xmyoot/esp32-p4-midi-lte/docs/client_brief/job_post_1_summary.png

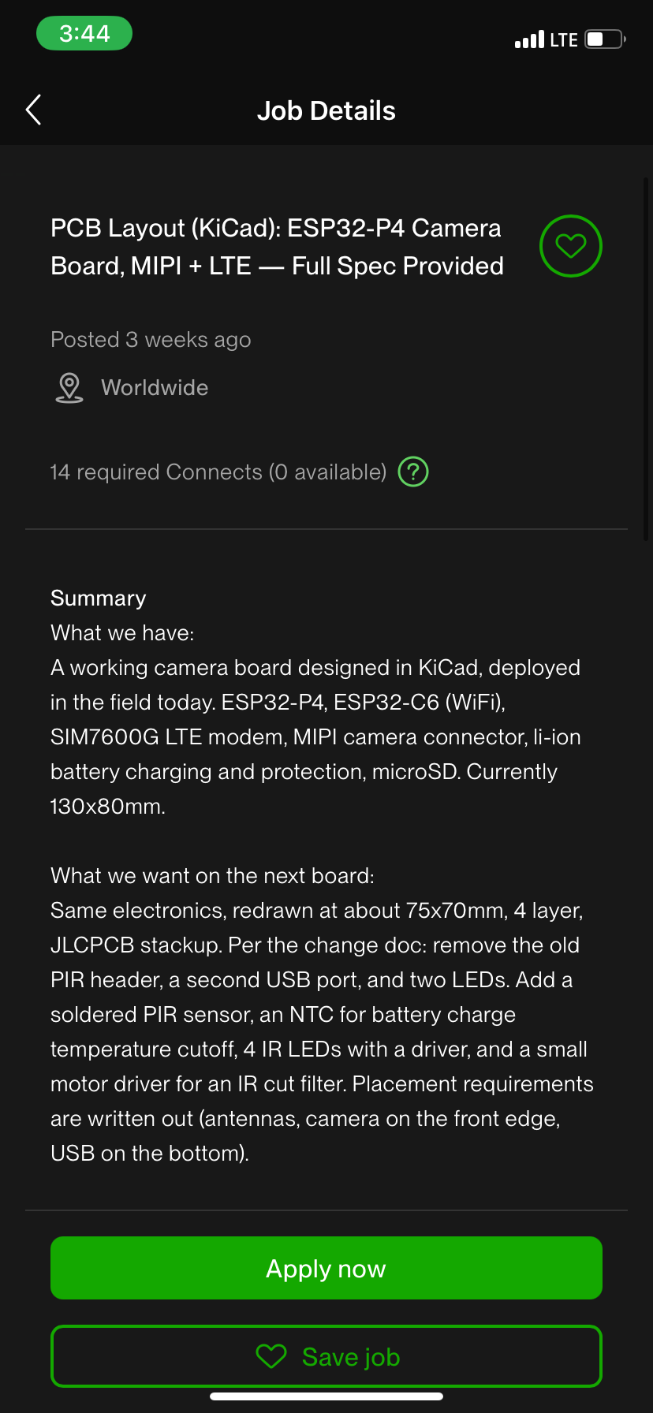
docs/client_brief/job_post_1_summary.png
