xmyoot/esp32-p4-midi-lte/docs/client_brief/job_post_2_deliverables.png

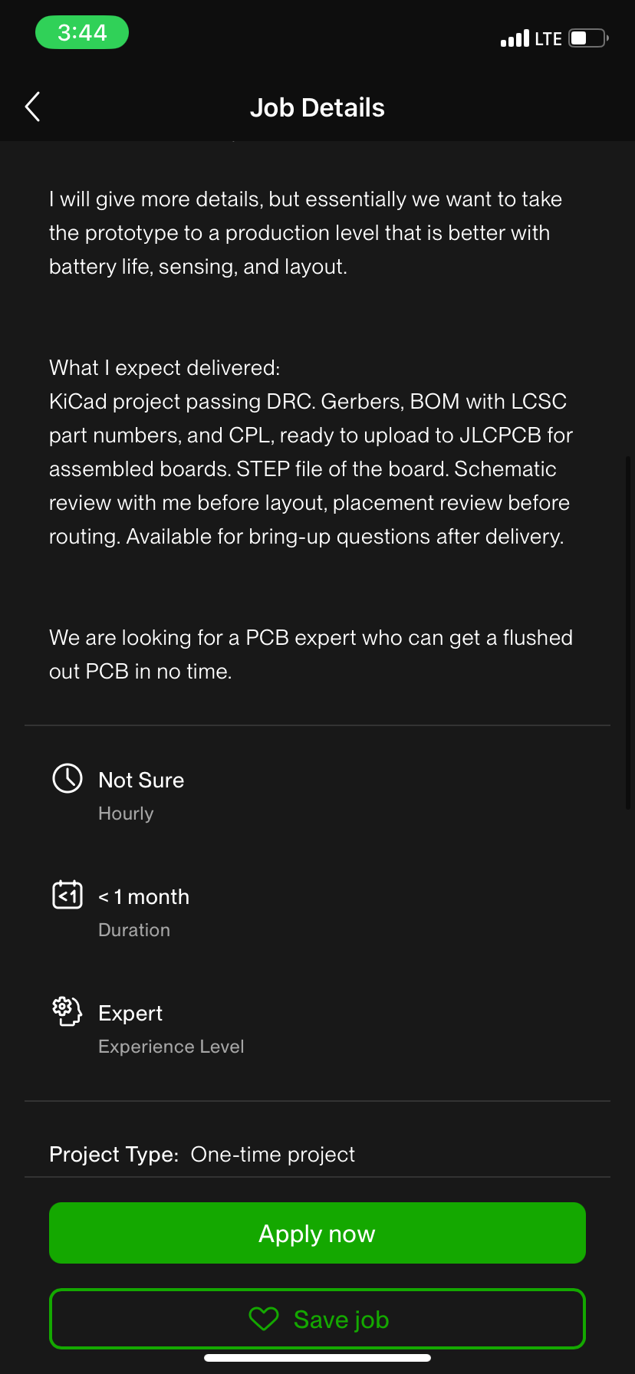
docs/client_brief/job_post_2_deliverables.png
