xmyoot/esp32-p4-midi-lte/docs/review/bom_revA_draft.csv

Refs | Value | Footprint | LCSC | MPN | Qty | DNP
C201 | 1u 25V | Capacitor_SMD:C_0603_1608Metric | C5673 | CL10A105KA8NNNC | 1
C202 | 10u 25V | Capacitor_SMD:C_0805_2012Metric | C15850 | CL21A106KAYNNNE | 1
C203,C328,C610 | 4.7u 10V | Capacitor_SMD:C_0603_1608Metric | C1705 | CL10A475KP8NNNC | 3
C204 | 47n 16V | Capacitor_SMD:C_0402_1005Metric | C307434 | CL05B473KO5NNNC | 1
C205,C206,C207,C508,C605,C607 | 10u 10V | Capacitor_SMD:C_0805_2012Metric | C17024 | CL21A106KPFNNNE | 6
C208,C213,C301,C302,C303,C304,C305,C306,C307,C311,C312,C313,C314,C317,C319,C320,C323,C326,C331,C336,C402,C504,C511,C512,C516,C602,C609,C611,C703 | 100n | Capacitor_SMD:C_0402_1005Metric | C1525 | CL05B104KO5NNNC | 29
C209,C211,C212,C330 | 22u 10V | Capacitor_SMD:C_0805_2012Metric | C380338 | TCC0805X5R226M100FT | 4
C214,C215,C316,C318,C321,C322,C325,C327,C403,C507,C604,C705 | 1u | Capacitor_SMD:C_0402_1005Metric | C52923 | CL05A105KA5NQNC | 12
C308,C309,C310,C315,C401,C503,C601,C702 | 10u 10V | Capacitor_SMD:C_0603_1608Metric | C19702 | CL10A106KP8NNNC | 8
C324 | 10n | Capacitor_SMD:C_0402_1005Metric | C15195 | CL05B103KB5NNNC | 1
C329,C332,C333 | 22p | Capacitor_SMD:C_0402_1005Metric | C1555 | 0402CG220J500NT | 3
C334,C335 | 18p | Capacitor_SMD:C_0402_1005Metric | C1549 | 0402CG180J500NT | 2
C501,C502 | 220u 6.3V | Capacitor_Tantalum_SMD:CP_EIA-3528-21_Kemet-B | C30242 | TLJB227M006R0500 | 2
C505,C513,C514,C515 | 33p | Capacitor_SMD:C_0402_1005Metric | C1562 | 0402CG330J500NT | 4
C506 | 10p | Capacitor_SMD:C_0402_1005Metric | C32949 | CL05C100JB5NNNC | 1
C509,C603,C704 | 1n 25V | Capacitor_SMD:C_0402_1005Metric | C541372 | CC0402KRX7R8BB102 | 3
C510,C608 | 100n 16V | Capacitor_SMD:C_0402_1005Metric | C1525 | CL05B104KO5NNNC | 2
C606 | 4.7u 25V | Capacitor_SMD:C_0805_2012Metric | C1779 | CL21A475KAQNNNE | 1
D201 | SMF5.0A (TVS) | Diode_SMD:D_SOD-123F | C193402 | SMF5.0A | 1
D601 | B5819W | Diode_SMD:D_SOD-123 | C8598 | B5819W SL | 1
D602,D603,D604,D605 | IR 850nm | lcsc:LED-SMD_3P-L3.8-W3.8_M3838E1IRS1G09 | C2833567 | M3838E1IRS1G09-850NM | 4
J1 | USB-C (bottom edge) | Connector_USB:USB_C_Receptacle_HRO_TYPE-C-31-M-12 | C165948 | TYPE-C-31-M-12 | 1
J2 | CAM FPC 22P 0.5mm | lcsc:CONN-SMD_05B20L22P | C22459552 | 05B20L22P | 1
J3 | microSD | lcsc:TF-SMD_TF-01A | C91145 | TF-01A | 1
J4 | Nano-SIM | lcsc:SIM-SMD_NANO-SIM-7P-H1.37 | C7529384 | NANO SIM 7P H1.37 | 1
J5 | U.FL MAIN | lcsc:RF-SMD_FRF05002-JSS103M | C88374 | U.FL-R-SMT-1(80) | 1
J6 | U.FL AUX | lcsc:RF-SMD_FRF05002-JSS103M | C88374 | U.FL-R-SMT-1(80) | 1
J7 | U.FL GNSS | lcsc:RF-SMD_FRF05002-JSS103M | C88374 | U.FL-R-SMT-1(80) | 1
J8 | BATT (+ / NTC / -) | Connector_JST:JST_PH_S3B-PH-SM4-TB_1x03-1MP_P2.00mm_Horizontal | C265101 | S3B-PH-SM4-TB(LF)(SN) | 1
J9 | IR-CUT | Connector_JST:JST_SH_SM02B-SRSS-TB_1x02-1MP_P1.00mm_Horizontal | C160402 | SM02B-SRSS-TB(LF)(SN) | 1
L201 | 2.2uH | lcsc:IND-SMD_L5.0-W5.0_SMNR5030 | C189797 | SMNR5030-2R2N | 1
L202 | 1uH | Inductor_SMD:L_1008_2520Metric | C98348 | WPN252012H1R0MT | 1
L301 | 2.2uH | Inductor_SMD:L_1008_2520Metric | C5832372 | FTC252012S2R2MBCA | 1
L601 | 10uH | lcsc:IND-SMD_L4.0-W4.0 | C38117 | SWPA4030S100MT | 1
Q201 | FS8205A | lcsc:SOT-23-6_L2.9-W1.6-P0.95-LS2.8-BR | C2830320 | FS8205A | 1
Q501,Q502 | 2N7002 | Package_TO_SOT_SMD:SOT-23 | C8545 | 2N7002 | 2
R201,R202 | 5.1k | Resistor_SMD:R_0402_1005Metric | C25905 | 0402WGF5101TCE | 2
R203,R204,R304,R305,R306,R307,R308,R309,R316,R317,R318,R319,R320,R321,R509,R510,R511 | 0 | Resistor_SMD:R_0402_1005Metric | C17168 | 0402WGF0000TCE | 17
R205 | 120 | Resistor_SMD:R_0402_1005Metric | C25079 | 0402WGF1200TCE | 1
R206 | 5.23k | Resistor_SMD:R_0402_1005Metric | C2933105 | FRC0402F5231TS | 1
R207 | 30.1k | Resistor_SMD:R_0402_1005Metric | C29402 | 0402WGF3012TCE | 1
R208,R209,R210,R310,R312,R313,R401,R402,R403,R404,R405,R406,R407,R408,R508,R603,R702,R703,R704,R705,R706,R707 | 10k | Resistor_SMD:R_0402_1005Metric | C25744 | 0402WGF1002TCE | 22
R211,R609 | 100 | Resistor_SMD:R_0402_1005Metric | C25076 | 0402WGF1000TCE | 2
R212,R311 | 1k | Resistor_SMD:R_0402_1005Metric | C11702 | 0402WGF1001TCE | 2
R213 | 560k | Resistor_SMD:R_0402_1005Metric | C137958 | RC0402FR-07560KL | 1
R214,R501,R502,R503,R504,R605,R607,R608,R708 | 100k | Resistor_SMD:R_0402_1005Metric | C25741 | 0402WGF1003TCE | 9
R301 | 4.02k | Resistor_SMD:R_0402_1005Metric | C43251 | 0402WGF4021TCE | 1
R302,R303 | 499k | Resistor_SMD:R_0402_1005Metric | C2998054 | FRC0402F4993TS | 2
R314,R315,R505,R506,R507,R701 | 22 | Resistor_SMD:R_0402_1005Metric | C25092 | 0402WGF220JTCE | 6
R601,R602 | 2.2k | Resistor_SMD:R_0402_1005Metric | C25879 | 0402WGF2201TCE | 2
R606 | 0.68 | Resistor_SMD:R_0805_2012Metric | C47389 | 0805W8F680LT5E | 1
SW301 | RESET | lcsc:SW-SMD_L4.0-W2.9-P4.15-EH | C455278 | TS-1088C-02026 | 1
SW302 | BOOT | lcsc:SW-SMD_L4.0-W2.9-P4.15-EH | C455278 | TS-1088C-02026 | 1
U1 | ESP32-P4NRW32X | espressif:ESP32-P4 | C54540373 | ESP32-P4NRW32X | 1
U2 | W25Q128JVSIQ | Package_SO:SOIC-8_5.3x5.3mm_P1.27mm | C97521 | W25Q128JVSIQ | 1
U3 | ESP32-C6-MINI-1 | espressif:ESP32-C6-MINI-1 | C5453904 | ESP32-C6-MINI-1-N4 | 1
U4 | SIM7600G-H | lcsc:COMM-SMD_135P-L30.0-W30.0_SIM7600G | C5355477 | SIM7600G-H | 1
U5 | BQ25895RTWR | Package_DFN_QFN:Texas_RTW_WQFN-24-1EP_4x4mm_P0.5mm_EP2.7x2.7mm_ThermalVias | C80200 | BQ25895RTWR | 1
U6 | TPS631000 | lcsc:SOT-583-8_L2.1-W1.2-P0.50-LS1.6-BL | C5219190 | TPS631000DRLR | 1
U7 | TLV62569 | Package_TO_SOT_SMD:SOT-23-5 | C141836 | TLV62569DBVR | 1
U8 | TPS7A0218 | lcsc:SOT-23-5_L3.0-W1.7-P0.95-LS2.8-BL | C5144851 | TPS7A0218DBVR | 1
U9 | TPS22965 | lcsc:UDFN-8_L2.0-W2.0-P0.50-TL-EP | C122837 | TPS22965DSGR | 1
U10,U11 | TPS22918 | lcsc:SOT-23-6_L2.9-W1.6-P0.95-LS2.8-BR | C131941 | TPS22918DBVR | 2
U12 | TPS61169 | lcsc:SC-70-5_L2.1-W1.3-P0.65-LS2.1-BR | C71045 | TPS61169DCKR | 1
U13 | DRV8837 | Package_SON:Texas_DSG0008A_WSON-8-1EP_2x2mm_P0.5mm_EP0.9x1.6mm | C39159 | DRV8837DSGR | 1
U14 | DW01A | Package_TO_SOT_SMD:SOT-23-6 | C351410 | DW01A | 1
U15 | TPS3839G33 (3.08V) | Package_TO_SOT_SMD:SOT-23 | C485802 | TPS3839G33DBZR | 1
U16 | SN74LVC1T45 | Package_TO_SOT_SMD:SOT-23-6 | C7843 | SN74LVC1T45DBVR | 1
U17,U18 | TPD4E05U06 | Package_SON:USON-10_2.5x1.0mm_P0.5mm | C138714 | TPD4E05U06DQAR | 2
U19 | XYC-PIR223D-S0 | lcsc:TO-5-3_L8.2-W8.2 | C2887901 | XYC-PIR223D-S0 | 1
Y1 | 40MHz 10ppm | Crystal:Crystal_SMD_3225-4Pin_3.2x2.5mm | C9010 | X322540MPB4SI | 1
Y2 | 32.768kHz | Crystal:Crystal_SMD_3215-2Pin_3.2x1.5mm | C32346 | Q13FC13500004 | 1
