xmyoot/esp32-p4-midi-lte/docs/BOARD_SETUP.md

# Phase 3 — Board setup

Generated by `scripts/build_pcb.py` (netlist → PCB sync) and `scripts/board_setup.py` (idempotent).

## Board

| Item | Value |
|---|---|
| Outline | 75 × 70 mm, R2 corners. Origin top-left. Aux/grid origin bottom-left (0, 70) for the CPL |
| Mounting | 4 × M2.5 plated (GND), H1–H4 at (3.5, 9.5), (71.5, 9.5), (3.5, 66.5), (71.5, 66.5) |
| Fab | JLCPCB 4-layer, 1.6 mm, ENIG, **Standard PCBA** (required for the 0.35 mm-pitch QFN and the THT PIR) |

## Stackup — JLC04161H-7628

| Layer | Use | Thickness | Dk |
|---|---|---|---|
| F.Cu (L1) | Components, RF, MIPI, USB, short high-speed | 35 µm | — |
| prepreg 7628 | | 0.2104 mm | 4.4 |
| In1.Cu (L2) | **Solid GND plane** (zone `GND_L2`, full board) | 15.2 µm | — |
| core | | 1.065 mm | 4.6 |
| In2.Cu (L3) | Power pours (SYS, 3V3, VBAT_LTE) + low-speed signals | 15.2 µm | — |
| prepreg 7628 | | 0.2104 mm | 4.4 |
| B.Cu (L4) | Signals, GND fill | 35 µm | — |

## Controlled impedance (L1 over L2)

From `scripts/impedance.py`: Hammerstad–Jensen microstrip, the IPC-2141A coupled approximation, and Wadell grounded-CPW. Expect ±5 %. **Confirm in the JLCPCB impedance calculator and order impedance control.**

| Interface | Target | Geometry | Model result |
|---|---|---|---|
| LTE/GNSS RF feeds | 50 Ω CPWG | w 0.30 mm, gap 0.20 mm | 47.0 Ω (thickness-corrected CPWG) to 53.7 Ω (microstrip bound) |
| USB 2.0 FS (USB-Serial/JTAG) | 90 Ω diff | w 0.22 mm, s 0.13 mm | 90.8 Ω |
| MIPI CSI-2 D-PHY | **100 Ω diff** | w 0.17 mm, s 0.13 mm | 100.6 Ω |
| Reference | 50 Ω microstrip | w 0.346 mm | Matches JLC's published value for this stackup |

## Rules (JLC capability-checked 2026-10-19)

| Rule | Value | JLC limit |
|---|---|---|
| Min track / clearance | 0.10 / 0.10 mm (0.09 inside the U1 courtyard) | 0.09 / 0.09 |
| Vias | **0.45/0.2 mm** (fine-pitch, no extra cost), 0.6/0.3 (default power), 0.8/0.4 | 0.25/0.15 min. Extra cost below 0.45 pad with 0.2 drill |
| Copper to edge | 0.3 mm | 0.2 routed |
| Hole-to-hole | 0.25 mm | 0.2 |

### Net classes (assigned by pattern in `esp32p4_lte_cam.kicad_pro`)

| Class | Track | Clearance | Via | Nets |
|---|---|---|---|---|
| Default | 0.127 | 0.127 | 0.45/0.2 | 107 |
| Power | 0.40 | 0.15 | 0.6/0.3 | 19: 3V3, 3V3_*, VDD_*, 1V8_IO6, IR string, IR-cut, modem 1V8, USIM_VDD |
| HighCurrent | 0.80 | 0.20 | 0.6/0.3 | 10: VBAT_LTE, SYS, BAT, BATN, VBUS, CHG_SW, CHG_PMID, BB_LX*, PROT_D |
| RF_50R | 0.30 | 0.20 | 0.45/0.2 | 6: ANT_*, RF_* |
| USB_90R | 0.22 (gap 0.13) | 0.15 | 0.45/0.2 | 6 |
| MIPI_100R | 0.17 (gap 0.13) | 0.15 | 0.45/0.2 | 12 |

### Custom rules (`esp32p4_lte_cam.kicad_dru`)

- 0.09 mm clearance and track inside the P4 courtyard (0.35 mm QFN fan-out)
- RF ground gap ≥ 0.2 mm
- USB: diff gap 0.12–0.14 mm, ≤ 3 mm uncoupled, ≤ 0.15 mm skew
- MIPI: diff gap 0.12–0.14 mm, ≤ 2 mm uncoupled, ≤ 0.1 mm intra-pair skew, lanes ≤ 40 mm
- HighCurrent vias: drill ≥ 0.3 mm

## Keep-outs

- **C6 antenna:** an all-copper-layer keep-out ships inside Espressif's ESP32-C6-MINI-1 footprint. Placing the module on the left edge puts it at the board edge.
- **SIM7600 top layer:** no routing under the module except on its pads (SIMCom layout guide). Added as a rule area once the modem is placed (Phase 4).

## Library fixes applied (`scripts/fix_lcsc_pins.py`)

- EasyEDA symbols: every "unspecified" pin is given a real electrical type, so ERC means something.
- Espressif P4 symbol: VDD_ANA and VDD_BAT changed from bidirectional to power_in.
- EasyEDA footprints: locating pegs imported as zero-annular PTH become **NPTH** (switches, nano-SIM, microSD). The PIR TO-5 courtyard is rebuilt as a clean Ø9.7 mm circle.

## Status

DRC 0 violations (`--severity-all --refill-zones`). 499 unrouted connections remain, as expected. All 231 footprints sit in a staging area at x > 110 mm and are ready for placement.
