xmyoot/esp32-p4-midi-lte/docs/review/placement/assembly_top.pdf

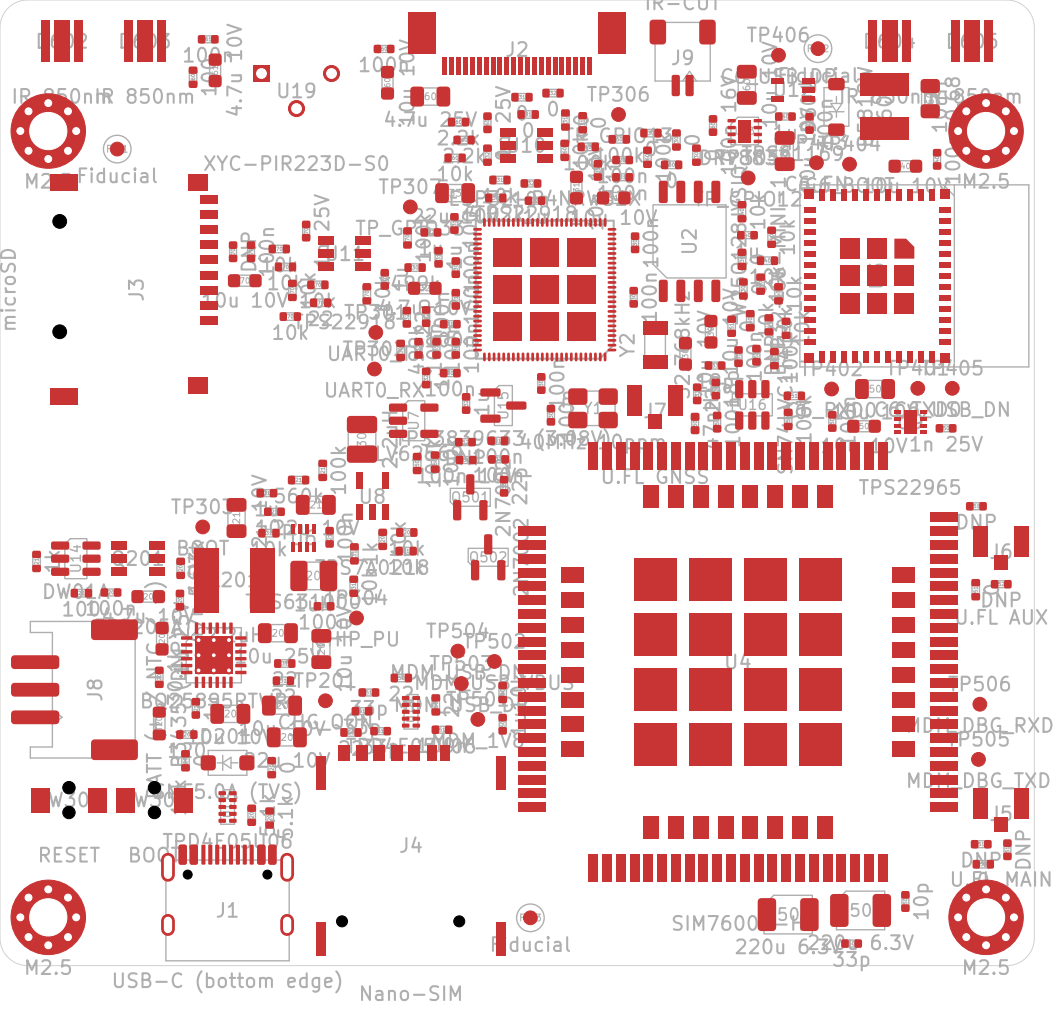
[picture p14: page 1]
