xmyoot/esp32-p4-midi-lte/esp32p4_lte_cam.kicad_pcb

## KiCad design esp32p4_lte_cam.kicad_pcb (2026-10-20)

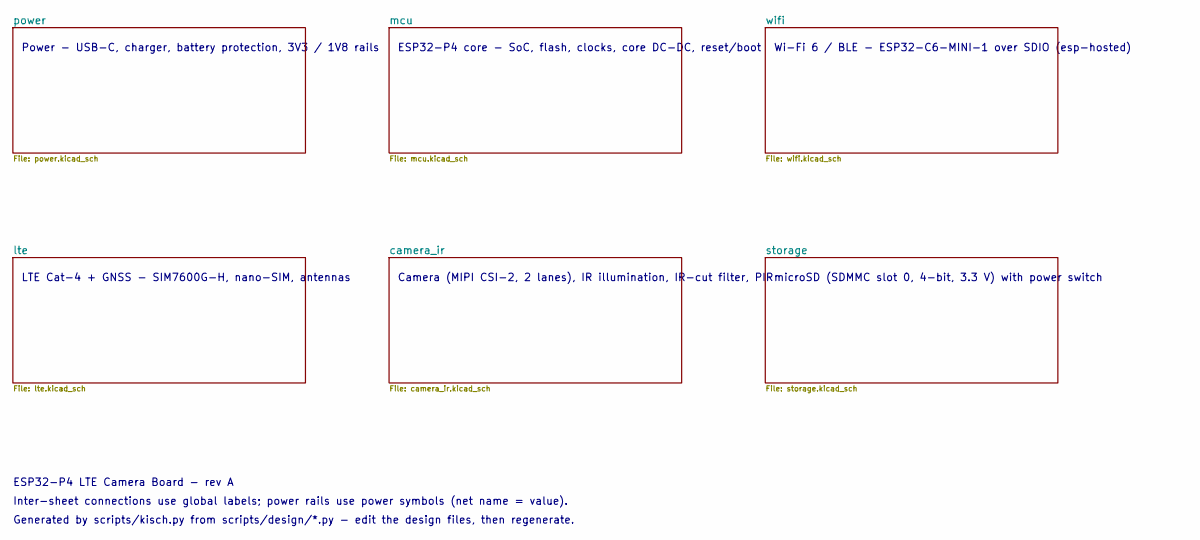
[picture p15: schematic esp32p4_lte_cam.kicad_sch, Top level / sheet index]

Notes on the sheet:
Power - USB-C, charger, battery protection, 3V3 / 1V8 rails
ESP32-P4 core - SoC, flash, clocks, core DC-DC, reset/boot
Wi-Fi 6 / BLE - ESP32-C6-MINI-1 over SDIO (esp-hosted)
LTE Cat-4 + GNSS - SIM7600G-H, nano-SIM, antennas
Camera (MIPI CSI-2, 2 lanes), IR illumination, IR-cut filter, PIR
microSD (SDMMC slot 0, 4-bit, 3.3 V) with power switch
ESP32-P4 LTE Camera Board - rev A
Inter-sheet connections use global labels; power rails use power symbols (net name = value).
Generated by scripts/kisch.py from scripts/design/*.py - edit the design files, then regenerate.

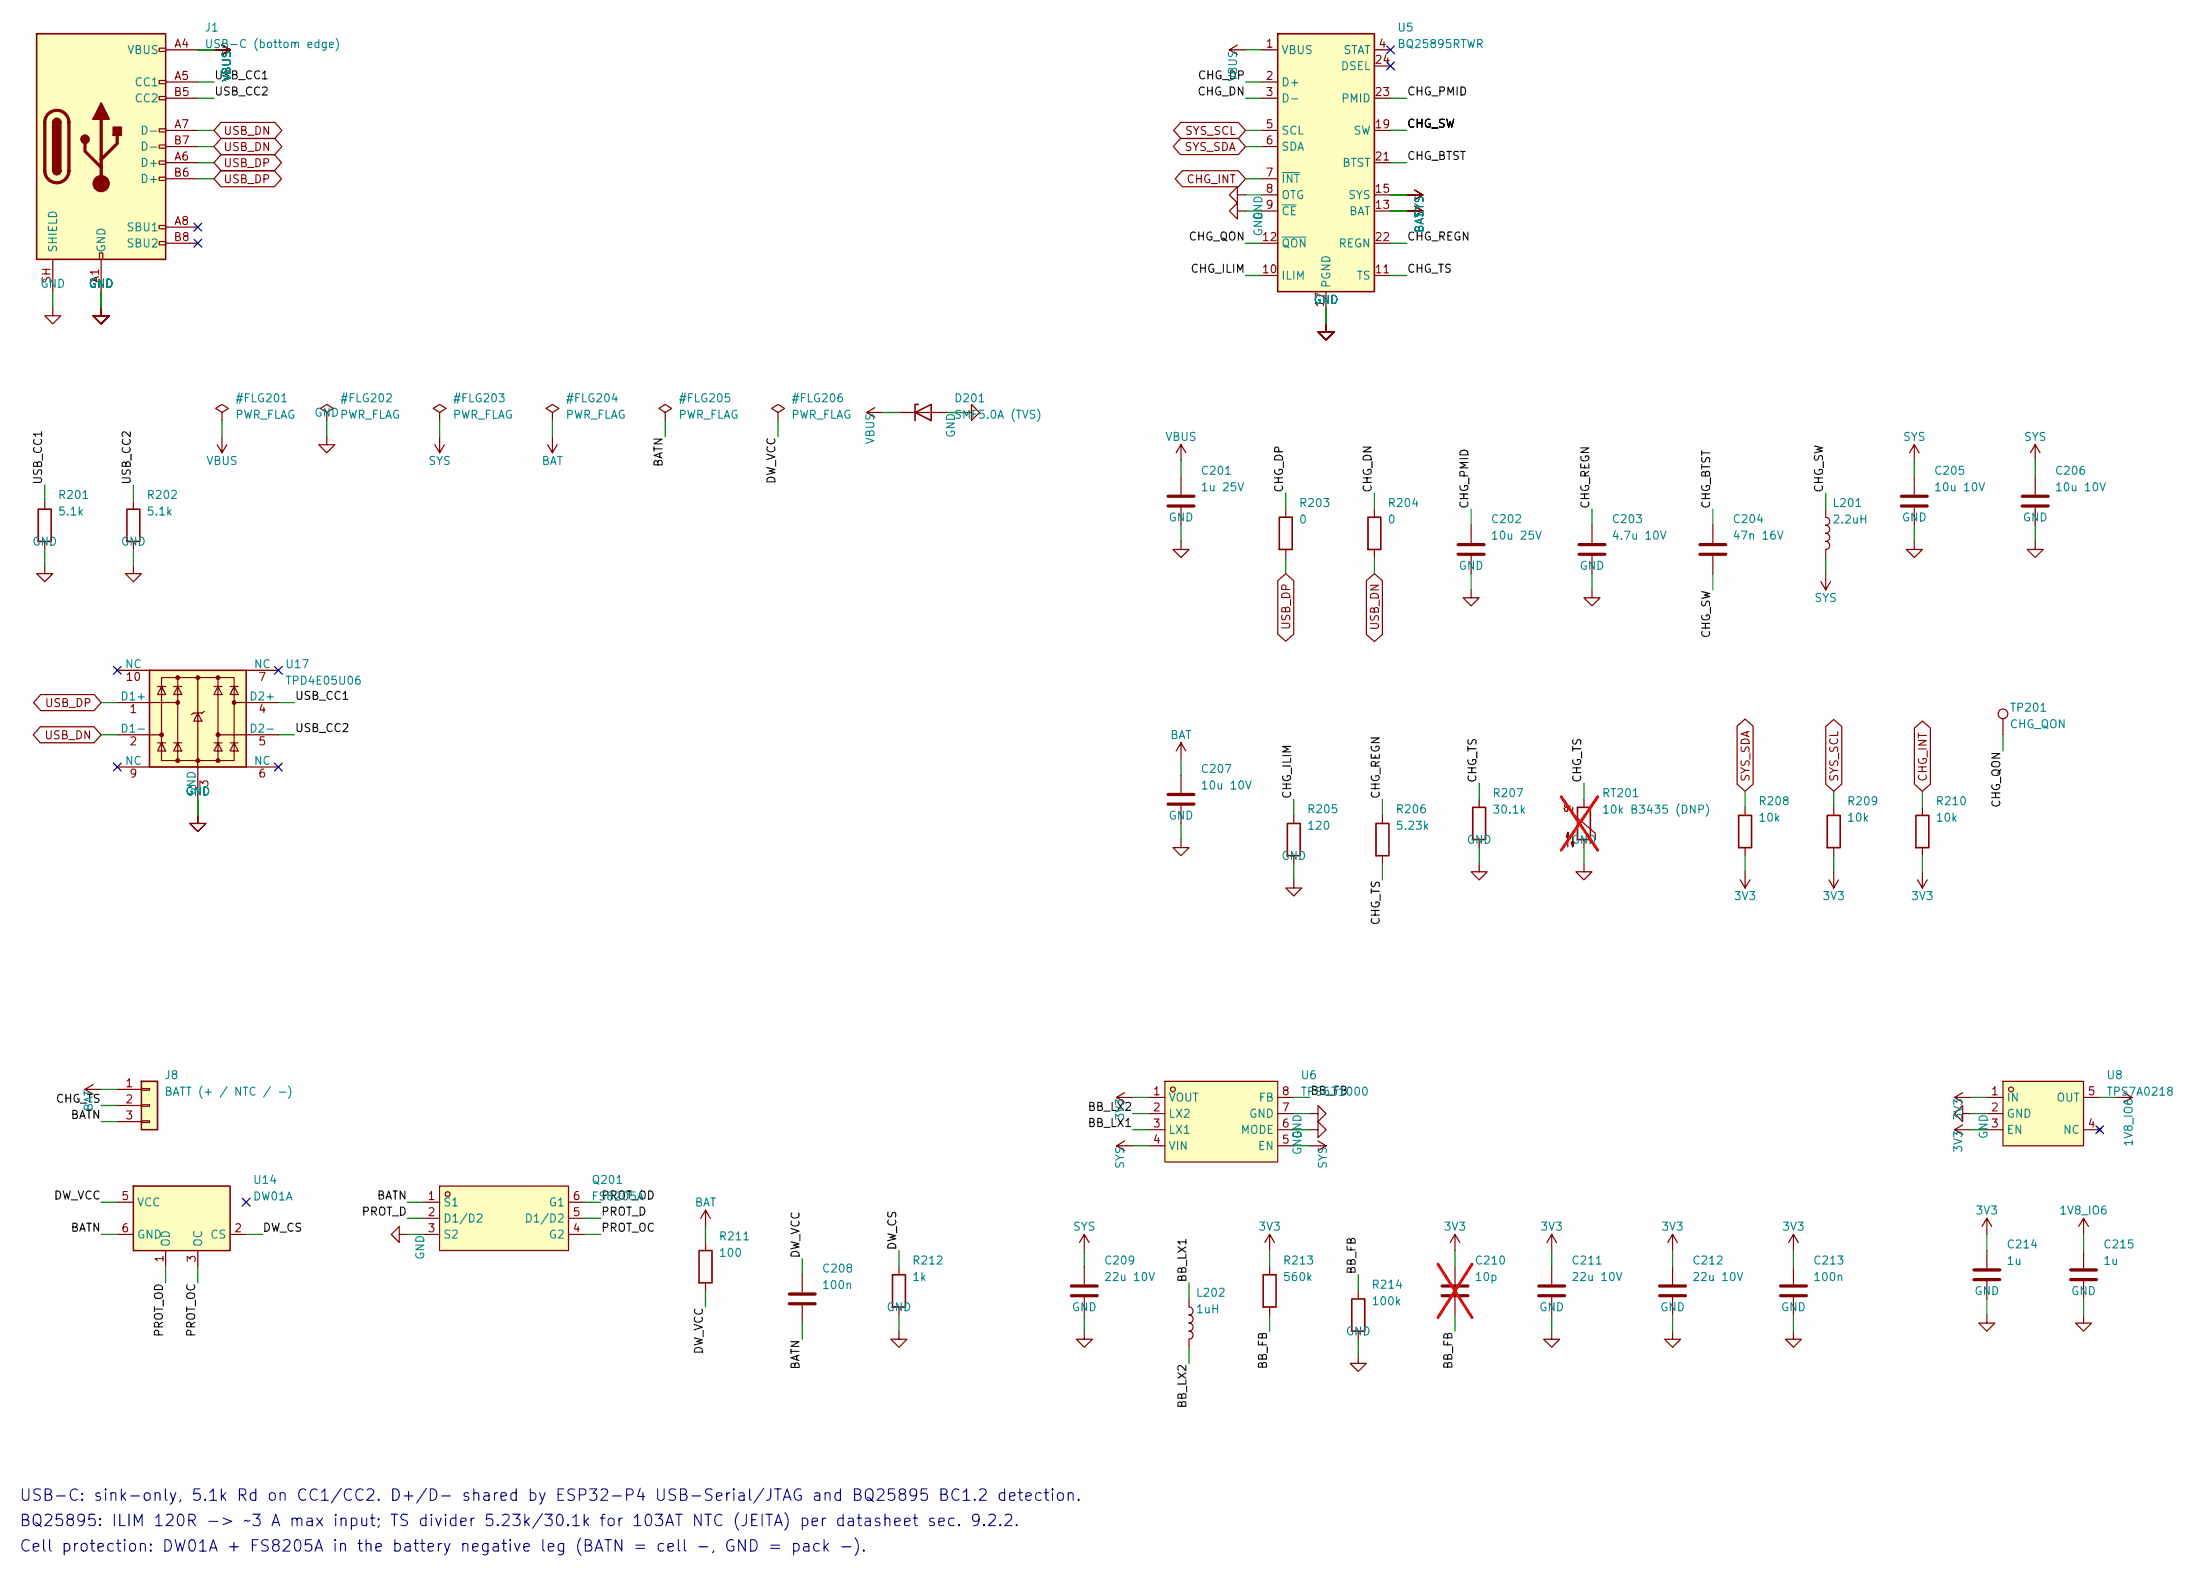
[picture p16: schematic power.kicad_sch, Power - USB-C, charger, battery protection, 3V3 / 1V8 rails]

Parts:
C201: 1u 25V; C_0603_1608Metric; MPN CL10A105KA8NNNC; LCSC C5673
C202: 10u 25V; C_0805_2012Metric; MPN CL21A106KAYNNNE; LCSC C15850
C203: 4.7u 10V; C_0603_1608Metric; MPN CL10A475KP8NNNC; LCSC C1705
C204: 47n 16V; C_0402_1005Metric; MPN CL05B473KO5NNNC; LCSC C307434
C205, C206, C207: 10u 10V; C_0805_2012Metric; MPN CL21A106KPFNNNE; LCSC C17024
C208, C213: 100n; C_0402_1005Metric; MPN CL05B104KO5NNNC; LCSC C1525
C209, C211, C212: 22u 10V; C_0805_2012Metric; MPN TCC0805X5R226M100FT; LCSC C380338
C210: 10p; C_0402_1005Metric; MPN CL05C100JB5NNNC; LCSC C32949; not fitted
C214, C215: 1u; C_0402_1005Metric; MPN CL05A105KA5NQNC; LCSC C52923
D201: SMF5.0A (TVS); D_SOD-123F; MPN SMF5.0A; LCSC C193402
J1: USB-C (bottom edge); USB_C_Receptacle_HRO_TYPE-C-31-M-12; MPN TYPE-C-31-M-12; LCSC C165948
J8: BATT (+ / NTC / -); JST_PH_S3B-PH-SM4-TB_1x03-1MP_P2.00mm_Horizontal; MPN S3B-PH-SM4-TB(LF)(SN); LCSC C265101
L201: 2.2uH; IND-SMD_L5.0-W5.0_SMNR5030; MPN SMNR5030-2R2N; LCSC C189797
L202: 1uH; L_1008_2520Metric; MPN WPN252012H1R0MT; LCSC C98348
Q201: FS8205A; SOT-23-6_L2.9-W1.6-P0.95-LS2.8-BR; MPN FS8205A; LCSC C2830320
R201, R202: 5.1k; R_0402_1005Metric; MPN 0402WGF5101TCE; LCSC C25905
R203, R204: 0; R_0402_1005Metric; MPN 0402WGF0000TCE; LCSC C17168
R205: 120; R_0402_1005Metric; MPN 0402WGF1200TCE; LCSC C25079
R206: 5.23k; R_0402_1005Metric; MPN FRC0402F5231TS; LCSC C2933105
R207: 30.1k; R_0402_1005Metric; MPN 0402WGF3012TCE; LCSC C29402
R208, R209, R210: 10k; R_0402_1005Metric; MPN 0402WGF1002TCE; LCSC C25744
R211: 100; R_0402_1005Metric; MPN 0402WGF1000TCE; LCSC C25076
R212: 1k; R_0402_1005Metric; MPN 0402WGF1001TCE; LCSC C11702
R213: 560k; R_0402_1005Metric; MPN RC0402FR-07560KL; LCSC C137958
R214: 100k; R_0402_1005Metric; MPN 0402WGF1003TCE; LCSC C25741
RT201: 10k B3435 (DNP); R_0603_1608Metric; MPN NCP18XH103F03RB; LCSC C13564; not fitted
TP201: CHG_QON; TestPoint_Pad_D1.0mm
U5: BQ25895RTWR; Texas_RTW_WQFN-24-1EP_4x4mm_P0.5mm_EP2.7x2.7mm_ThermalVias; MPN BQ25895RTWR; LCSC C80200
U6: TPS631000; SOT-583-8_L2.1-W1.2-P0.50-LS1.6-BL; MPN TPS631000DRLR; LCSC C5219190
U8: TPS7A0218; SOT-23-5_L3.0-W1.7-P0.95-LS2.8-BL; MPN TPS7A0218DBVR; LCSC C5144851
U14: DW01A; SOT-23-6; MPN DW01A; LCSC C351410
U17: TPD4E05U06; USON-10_2.5x1.0mm_P0.5mm; MPN TPD4E05U06DQAR; LCSC C138714

Connections:
1V8_IO6: C215.1, U8.5 (OUT); also elsewhere on the board
3V3: C210.1, C211.1, C212.1, C213.1, C214.1, R208.2, R209.2, R210.2, R213.1, U6.1 (VOUT), U8.1 (IN), U8.3 (EN); also elsewhere on the board
/power/BATN: C208.2, J8.3, Q201.1 (S1), U14.6 (GND)
/power/BB_FB: C210.2, R213.2, R214.1, U6.8 (FB)
/power/BB_LX1: L202.1, U6.3 (LX1)
/power/BB_LX2: L202.2, U6.2 (LX2)
/power/CHG_BTST: C204.1, U5.21 (BTST)
/power/CHG_DN: R204.1, U5.3 (D-)
/power/CHG_DP: R203.1, U5.2 (D+)
/power/CHG_ILIM: R205.1, U5.10 (ILIM)
/power/CHG_PMID: C202.1, U5.23 (PMID)
/power/CHG_QON: TP201.1, U5.12 (~QON)
/power/CHG_REGN: C203.1, R206.1, U5.22 (REGN)
/power/CHG_SW: C204.2, L201.1, U5.19 (SW), U5.20 (SW)
/power/CHG_TS: J8.2, R206.2, R207.1, RT201.1, U5.11 (TS)
/power/DW_CS: R212.1, U14.2 (CS)
/power/DW_VCC: C208.1, R211.2, U14.5 (VCC)
/power/PROT_D: Q201.2 (D1/D2), Q201.5 (D1/D2)
/power/PROT_OC: Q201.4 (G2), U14.3 (OC)
/power/PROT_OD: Q201.6 (G1), U14.1 (OD)
/power/USB_CC1: J1.A5 (CC1), R201.1, U17.4 (D2+)
/power/USB_CC2: J1.B5 (CC2), R202.1, U17.5 (D2-)
BAT: C207.1, J8.1, R211.1, U5.13 (BAT), U5.14 (BAT)
CHG_INT: R210.1, U5.7 (~INT); also elsewhere on the board
GND: C201.2, C202.2, C203.2, C205.2, C206.2, C207.2, C209.2, C211.2, C212.2, C213.2, C214.2, C215.2, D201.2 (A), J1.A1 (GND), J1.A12 (GND), J1.B1 (GND), J1.B12 (GND), J1.SH (SHIELD), Q201.3 (S2), R201.2, R202.2, R205.2, R207.2, R212.2, R214.2, RT201.2, U5.8 (OTG), U5.9 (~CE), U5.17 (PGND), U5.18 (PGND), U5.25 (PGND), U6.6 (MODE), U6.7 (GND), U8.2 (GND), U17.3 (GND), U17.8 (GND); also elsewhere on the board
SYS: C205.1, C206.1, C209.1, L201.2, U5.15 (SYS), U5.16 (SYS), U6.4 (VIN), U6.5 (EN); also elsewhere on the board
SYS_SCL: R209.1, U5.5 (SCL); also elsewhere on the board
SYS_SDA: R208.1, U5.6 (SDA); also elsewhere on the board
USB_DN: J1.A7 (D-), J1.B7 (D-), R204.2, U17.2 (D1-); also elsewhere on the board
USB_DP: J1.A6 (D+), J1.B6 (D+), R203.2, U17.1 (D1+); also elsewhere on the board
VBUS: C201.1, D201.1 (K), J1.A4 (VBUS), J1.A9 (VBUS), J1.B4 (VBUS), J1.B9 (VBUS), U5.1 (VBUS)

Notes on the sheet:
USB-C: sink-only, 5.1k Rd on CC1/CC2. D+/D- shared by ESP32-P4 USB-Serial/JTAG and BQ25895 BC1.2 detection.
BQ25895: ILIM 120R -> ~3 A max input; TS divider 5.23k/30.1k for 103AT NTC (JEITA) per datasheet sec. 9.2.2.
Cell protection: DW01A + FS8205A in the battery negative leg (BATN = cell -, GND = pack -).

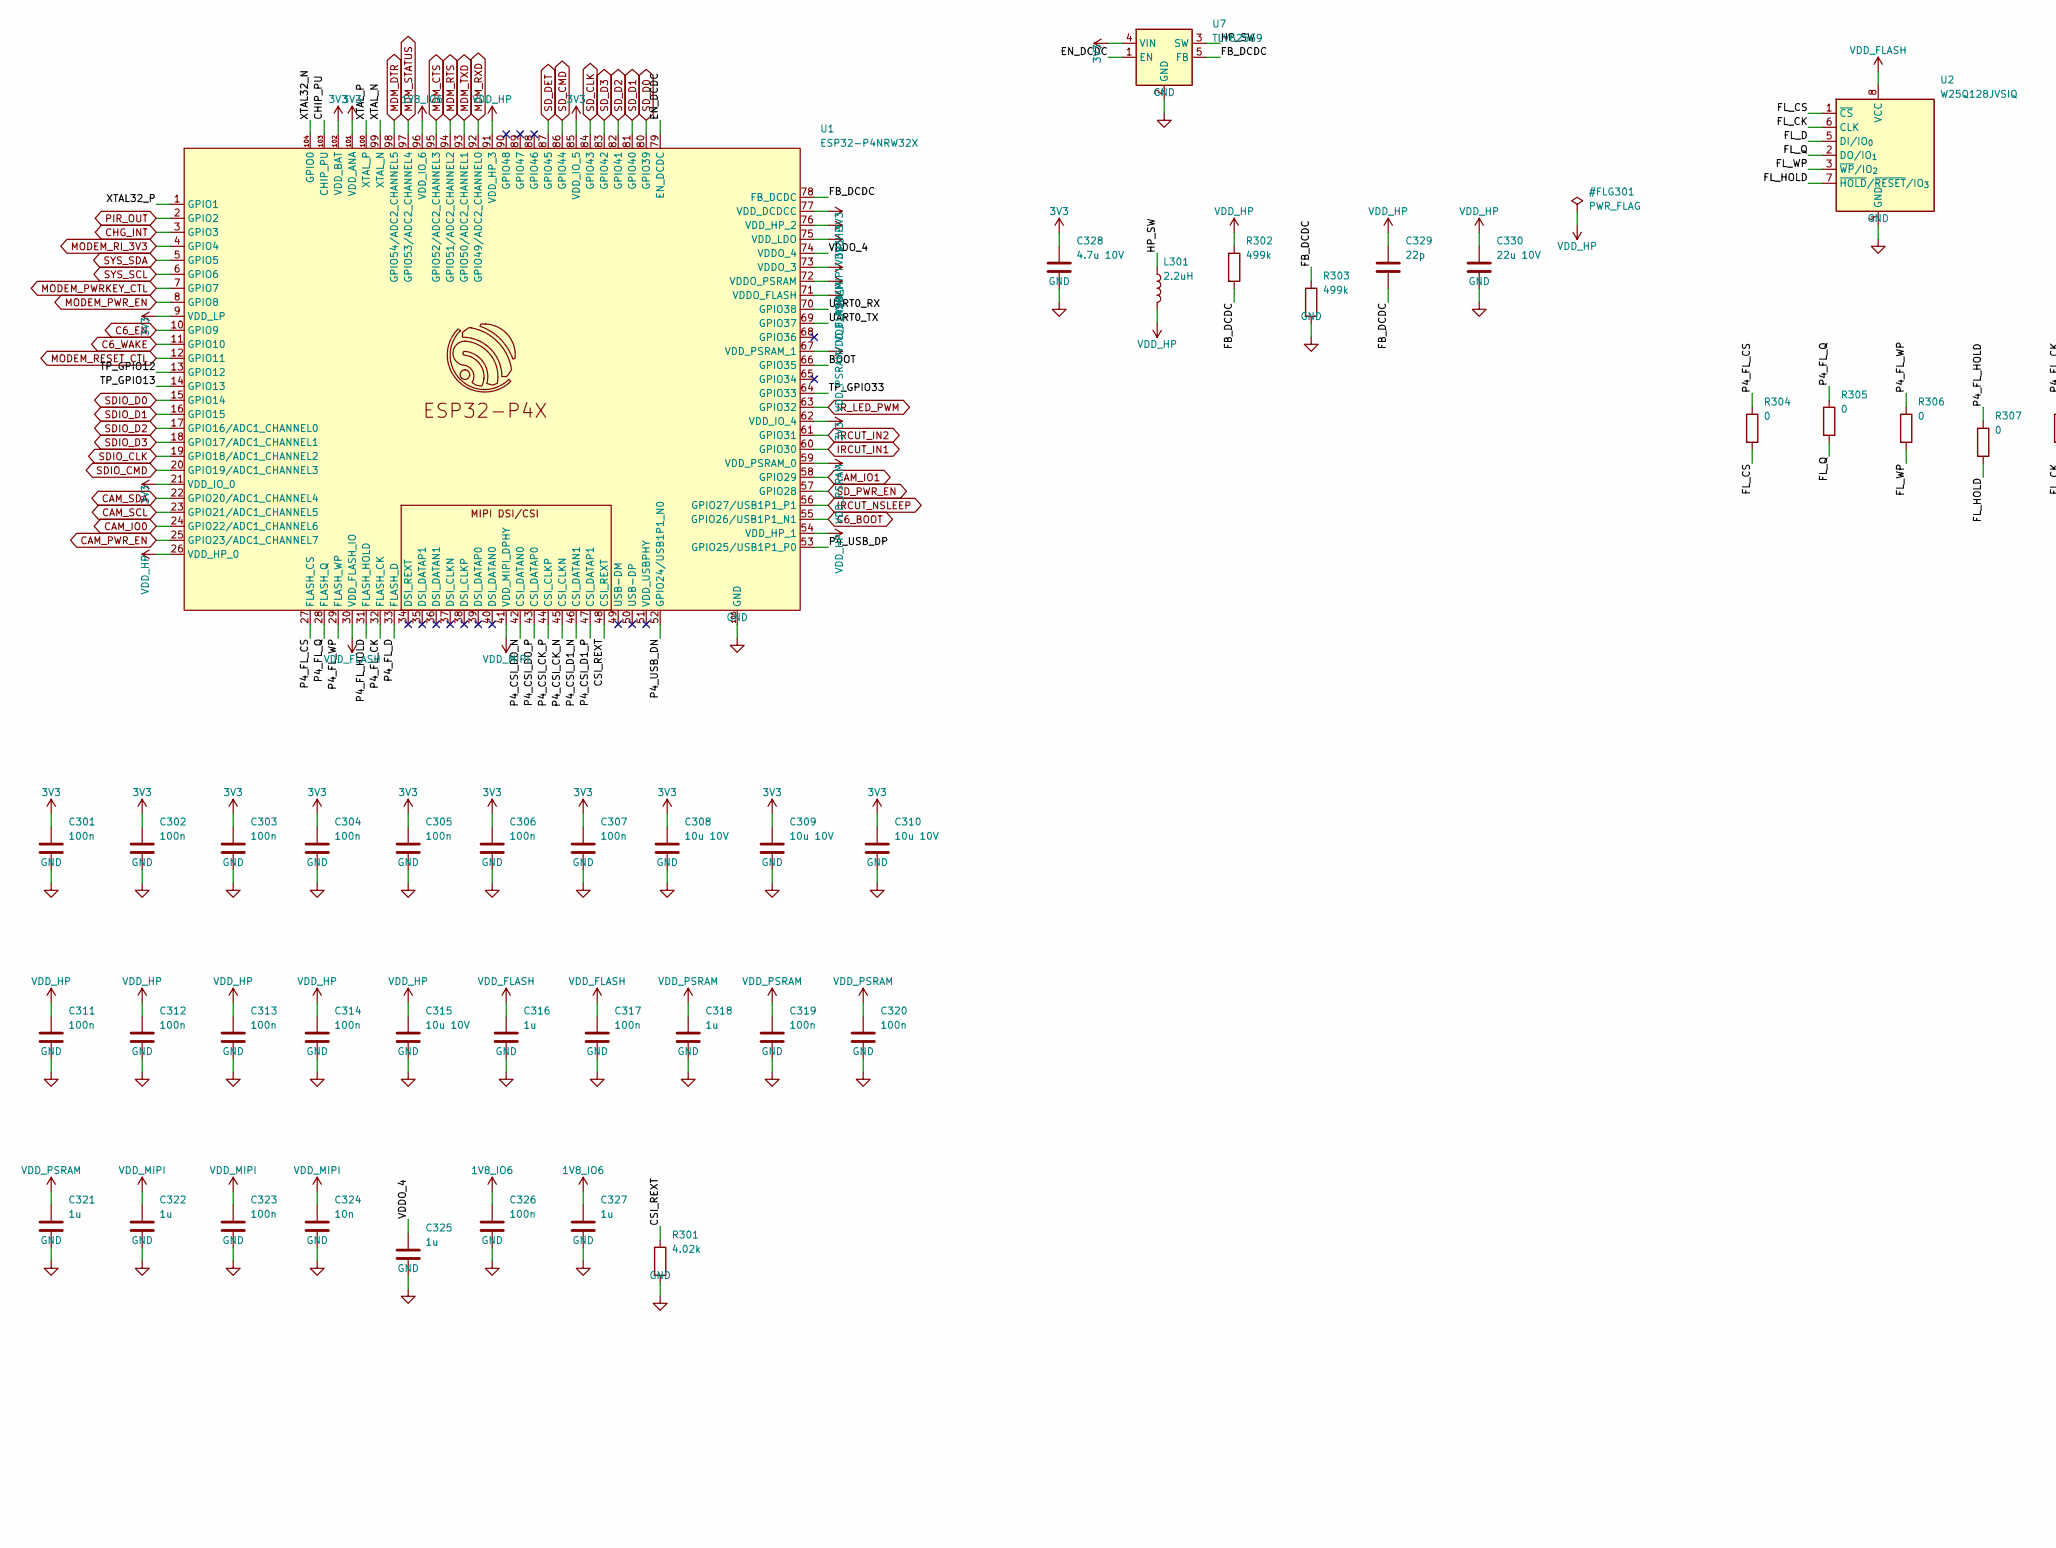
[picture p17: schematic mcu.kicad_sch, ESP32-P4 core - SoC, flash, clocks, core DC-DC, reset/boot, part in row 1, column 1]

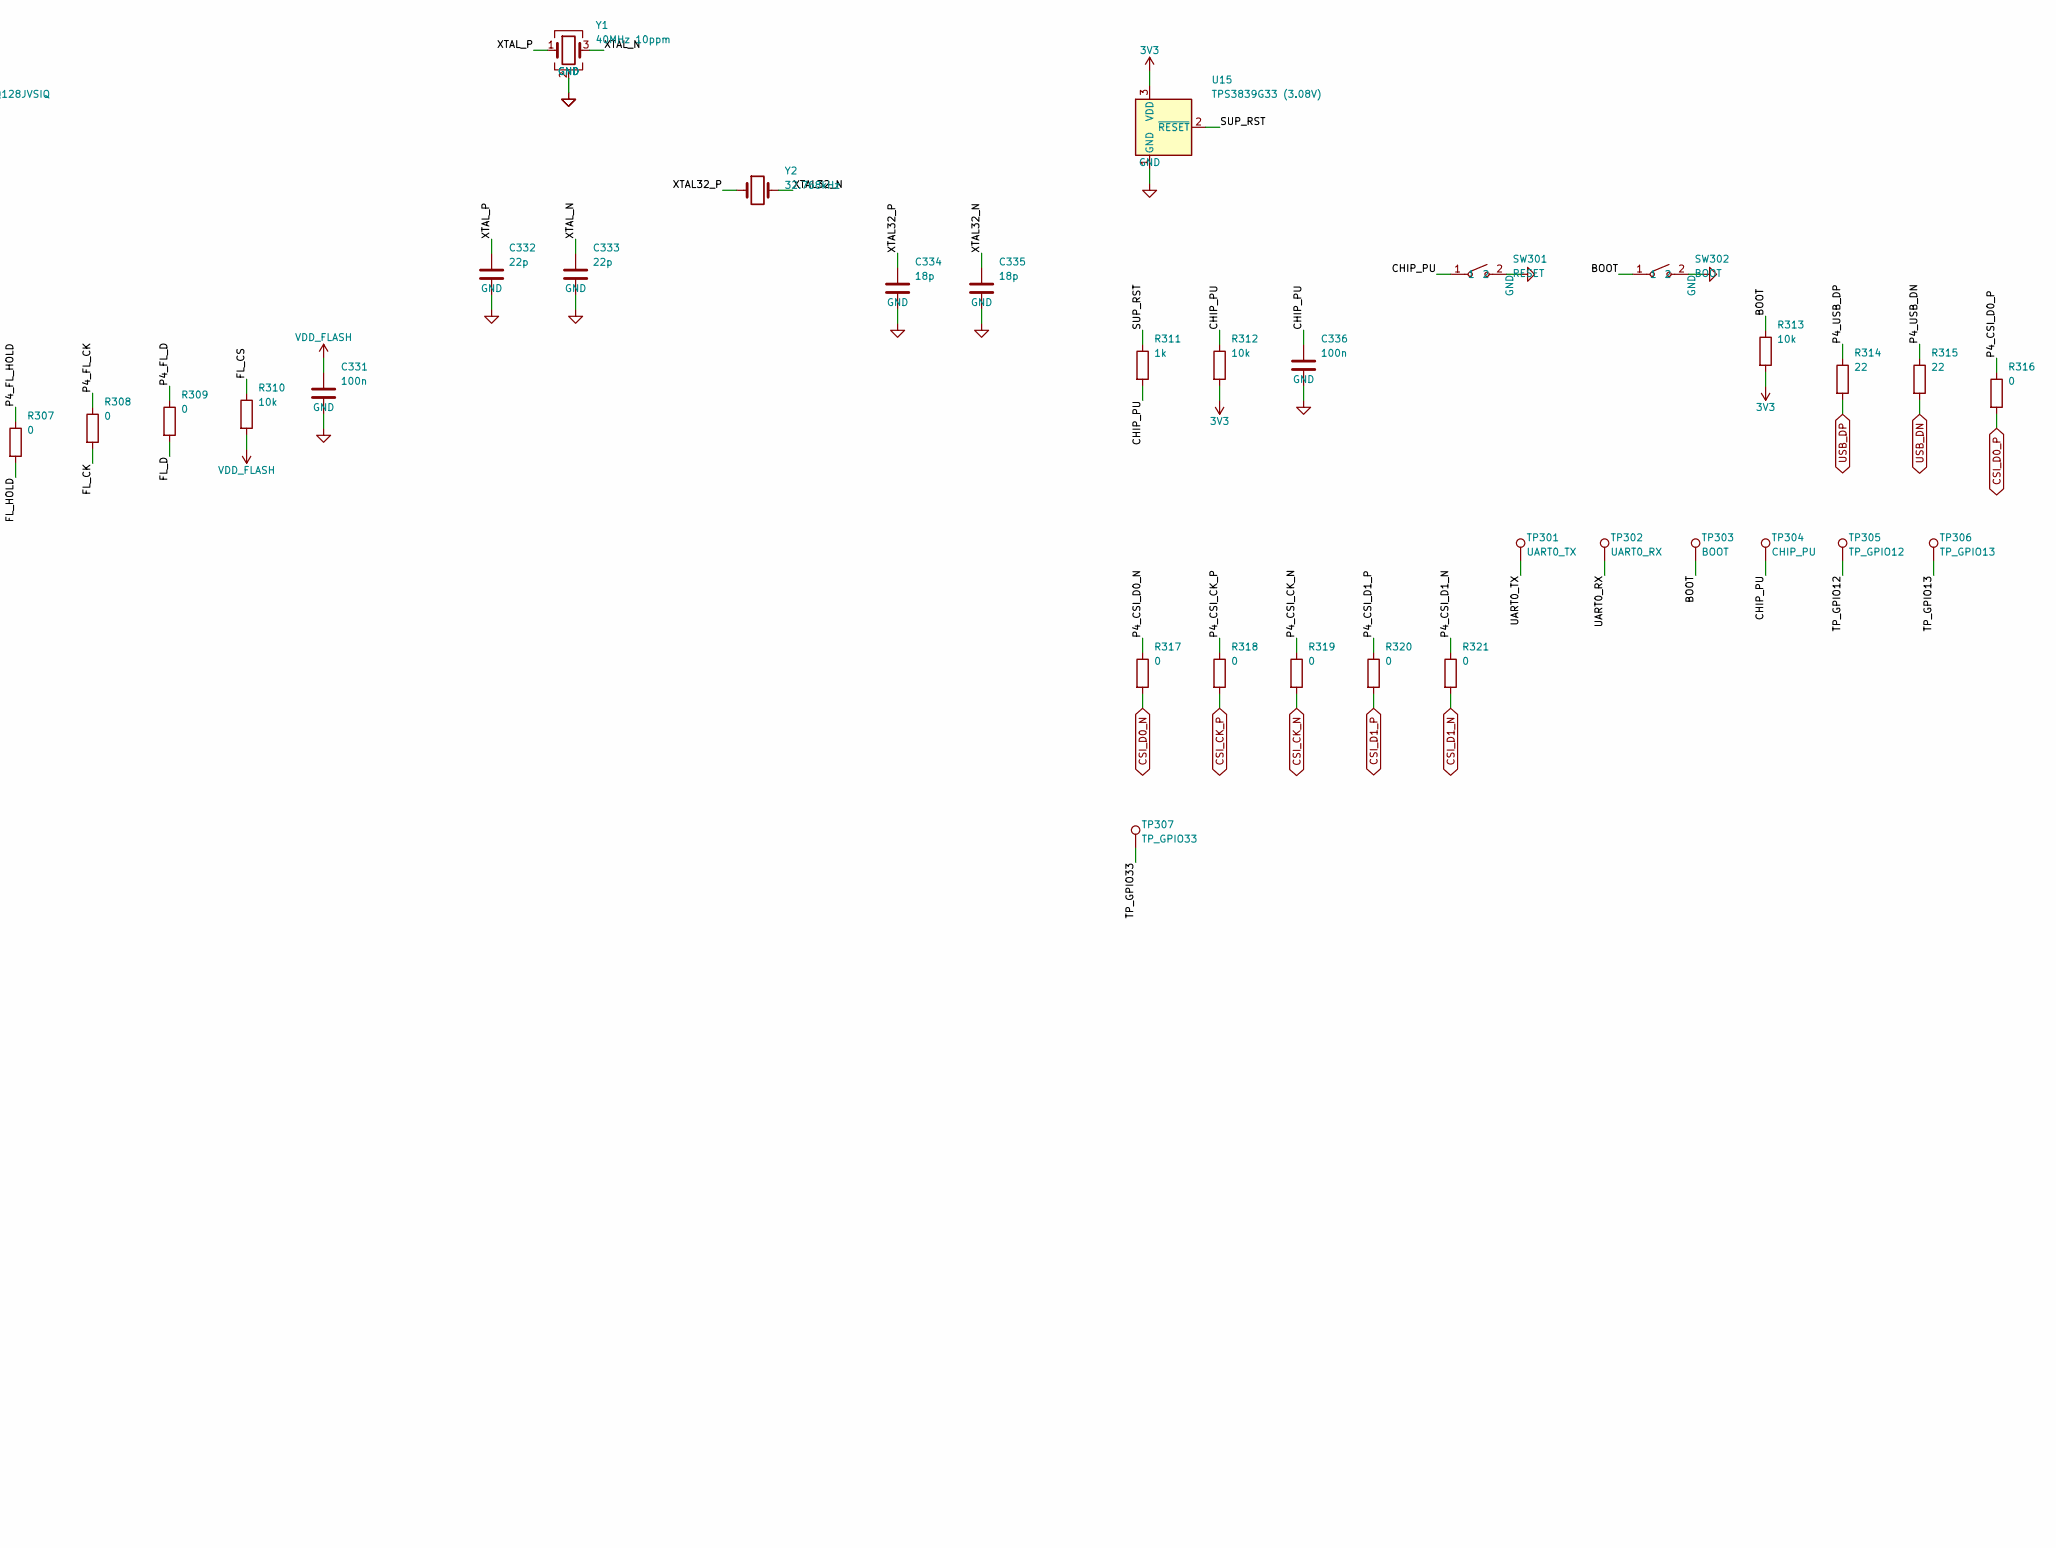
[picture p18: schematic mcu.kicad_sch, ESP32-P4 core - SoC, flash, clocks, core DC-DC, reset/boot, part in row 1, column 2]

Parts:
C301, C302, C303, C304, C305, C306, C307, C311, C312, C313, C314, C317, C319, C320, C323, C326, C331, C336: 100n; C_0402_1005Metric; MPN CL05B104KO5NNNC; LCSC C1525
C308, C309, C310, C315: 10u 10V; C_0603_1608Metric; MPN CL10A106KP8NNNC; LCSC C19702
C316, C318, C321, C322, C325, C327: 1u; C_0402_1005Metric; MPN CL05A105KA5NQNC; LCSC C52923
C324: 10n; C_0402_1005Metric; MPN CL05B103KB5NNNC; LCSC C15195
C328: 4.7u 10V; C_0603_1608Metric; MPN CL10A475KP8NNNC; LCSC C1705
C329, C332, C333: 22p; C_0402_1005Metric; MPN 0402CG220J500NT; LCSC C1555
C330: 22u 10V; C_0805_2012Metric; MPN TCC0805X5R226M100FT; LCSC C380338
C334, C335: 18p; C_0402_1005Metric; MPN 0402CG180J500NT; LCSC C1549
L301: 2.2uH; L_1008_2520Metric; MPN FTC252012S2R2MBCA; LCSC C5832372
R301: 4.02k; R_0402_1005Metric; MPN 0402WGF4021TCE; LCSC C43251
R302, R303: 499k; R_0402_1005Metric; MPN FRC0402F4993TS; LCSC C2998054
R304, R305, R306, R307, R308, R309, R316, R317, R318, R319, R320, R321: 0; R_0402_1005Metric; MPN 0402WGF0000TCE; LCSC C17168
R310, R312, R313: 10k; R_0402_1005Metric; MPN 0402WGF1002TCE; LCSC C25744
R311: 1k; R_0402_1005Metric; MPN 0402WGF1001TCE; LCSC C11702
R314, R315: 22; R_0402_1005Metric; MPN 0402WGF220JTCE; LCSC C25092
SW301: RESET; SW-SMD_L4.0-W2.9-P4.15-EH; MPN TS-1088C-02026; LCSC C455278
SW302: BOOT; SW-SMD_L4.0-W2.9-P4.15-EH; MPN TS-1088C-02026; LCSC C455278
TP301: UART0_TX; TestPoint_Pad_D1.0mm
TP302: UART0_RX; TestPoint_Pad_D1.0mm
TP303: BOOT; TestPoint_Pad_D1.0mm
TP304: CHIP_PU; TestPoint_Pad_D1.0mm
TP305: TP_GPIO12; TestPoint_Pad_D1.0mm
TP306: TP_GPIO13; TestPoint_Pad_D1.0mm
TP307: TP_GPIO33; TestPoint_Pad_D1.0mm
U1: ESP32-P4NRW32X; ESP32-P4; MPN ESP32-P4NRW32X; LCSC C54540373
U2: W25Q128JVSIQ; SOIC-8_5.3x5.3mm_P1.27mm; MPN W25Q128JVSIQ; LCSC C97521
U7: TLV62569; SOT-23-5; MPN TLV62569DBVR; LCSC C141836
U15: TPS3839G33 (3.08V); SOT-23; MPN TPS3839G33DBZR; LCSC C485802
Y1: 40MHz 10ppm; Crystal_SMD_3225-4Pin_3.2x2.5mm; MPN X322540MPB4SI; LCSC C9010
Y2: 32.768kHz; Crystal_SMD_3215-2Pin_3.2x1.5mm; MPN Q13FC13500004; LCSC C32346

Connections:
1V8_IO6: C326.1, C327.1, U1.96 (VDD_IO_6); also elsewhere on the board
3V3: C301.1, C302.1, C303.1, C304.1, C305.1, C306.1, C307.1, C308.1, C309.1, C310.1, C328.1, R312.2, R313.2, U1.9 (VDD_LP), U1.21 (VDD_IO_0), U1.62 (VDD_IO_4), U1.75 (VDD_LDO), U1.77 (VDD_DCDCC), U1.85 (VDD_IO_5), U1.101 (VDD_ANA), U1.102 (VDD_BAT), U7.4 (VIN), U15.3 (VDD); also elsewhere on the board
/mcu/BOOT: R313.1, SW302.1, TP303.1, U1.66 (GPIO35)
/mcu/CHIP_PU: C336.1, R311.2, R312.1, SW301.1, TP304.1, U1.103 (CHIP_PU)
/mcu/CSI_REXT: R301.1, U1.48 (CSI_REXT)
/mcu/EN_DCDC: U1.79 (EN_DCDC), U7.1 (EN)
/mcu/FB_DCDC: C329.2, R302.2, R303.1, U1.78 (FB_DCDC), U7.5 (FB)
/mcu/FL_CK: R308.2, U2.6 (CLK)
/mcu/FL_CS: R304.2, R310.1, U2.1 (~CS)
/mcu/FL_D: R309.2, U2.5 (DI/IO_{0})
/mcu/FL_HOLD: R307.2, U2.7 (~HOLD/~RESET/IO_{3})
/mcu/FL_Q: R305.2, U2.2 (DO/IO_{1})
/mcu/FL_WP: R306.2, U2.3 (~WP/IO_{2})
/mcu/HP_SW: L301.1, U7.3 (SW)
/mcu/P4_CSI_CK_N: R319.1, U1.45 (CSI_CLKN)
/mcu/P4_CSI_CK_P: R318.1, U1.44 (CSI_CLKP)
/mcu/P4_CSI_D0_N: R317.1, U1.42 (CSI_DATAN0)
/mcu/P4_CSI_D0_P: R316.1, U1.43 (CSI_DATAP0)
/mcu/P4_CSI_D1_N: R321.1, U1.46 (CSI_DATAN1)
/mcu/P4_CSI_D1_P: R320.1, U1.47 (CSI_DATAP1)
/mcu/P4_FL_CK: R308.1, U1.32 (FLASH_CK)
/mcu/P4_FL_CS: R304.1, U1.27 (FLASH_CS)
/mcu/P4_FL_D: R309.1, U1.33 (FLASH_D)
/mcu/P4_FL_HOLD: R307.1, U1.31 (FLASH_HOLD)
/mcu/P4_FL_Q: R305.1, U1.28 (FLASH_Q)
/mcu/P4_FL_WP: R306.1, U1.29 (FLASH_WP)
/mcu/P4_USB_DN: R315.1, U1.52 (GPIO24/USB1P1_N0)
/mcu/P4_USB_DP: R314.1, U1.53 (GPIO25/USB1P1_P0)
/mcu/SUP_RST: R311.1, U15.2 (~RESET)
/mcu/TP_GPIO12: TP305.1, U1.13 (GPIO12)
/mcu/TP_GPIO13: TP306.1, U1.14 (GPIO13)
/mcu/TP_GPIO33: TP307.1, U1.64 (GPIO33)
/mcu/UART0_RX: TP302.1, U1.70 (GPIO38)
/mcu/UART0_TX: TP301.1, U1.69 (GPIO37)
/mcu/VDDO_4: C325.1, U1.74 (VDDO_4)
/mcu/XTAL32_N: C335.1, U1.104 (GPIO0), Y2.2
/mcu/XTAL32_P: C334.1, U1.1 (GPIO1), Y2.1
/mcu/XTAL_N: C333.1, U1.99 (XTAL_N), Y1.3
/mcu/XTAL_P: C332.1, U1.100 (XTAL_P), Y1.1
C6_BOOT: U1.55 (GPIO26/USB1P1_N1); also elsewhere on the board
C6_EN: U1.10 (GPIO9); also elsewhere on the board
C6_WAKE: U1.11 (GPIO10); also elsewhere on the board
CAM_IO0: U1.24 (GPIO22/ADC1_CHANNEL6); also elsewhere on the board
CAM_IO1: U1.58 (GPIO29); also elsewhere on the board
CAM_PWR_EN: U1.25 (GPIO23/ADC1_CHANNEL7); also elsewhere on the board
CAM_SCL: U1.23 (GPIO21/ADC1_CHANNEL5); also elsewhere on the board
CAM_SDA: U1.22 (GPIO20/ADC1_CHANNEL4); also elsewhere on the board
CHG_INT: U1.3 (GPIO3); also elsewhere on the board
CSI_CK_N: R319.2; also elsewhere on the board
CSI_CK_P: R318.2; also elsewhere on the board
CSI_D0_N: R317.2; also elsewhere on the board
CSI_D0_P: R316.2; also elsewhere on the board
CSI_D1_N: R321.2; also elsewhere on the board
CSI_D1_P: R320.2; also elsewhere on the board
GND: C301.2, C302.2, C303.2, C304.2, C305.2, C306.2, C307.2, C308.2, C309.2, C310.2, C311.2, C312.2, C313.2, C314.2, C315.2, C316.2, C317.2, C318.2, C319.2, C320.2, C321.2, C322.2, C323.2, C324.2, C325.2, C326.2, C327.2, C328.2, C330.2, C331.2, C332.2, C333.2, C334.2, C335.2, C336.2, R301.2, R303.2, SW301.2, SW302.2, U1.105 (GND), U2.4 (GND), U7.2 (GND), U15.1 (GND), Y1.2 (G), Y1.4 (G); also elsewhere on the board
IRCUT_IN1: U1.60 (GPIO30); also elsewhere on the board
IRCUT_IN2: U1.61 (GPIO31); also elsewhere on the board
IRCUT_NSLEEP: U1.56 (GPIO27/USB1P1_P1); also elsewhere on the board
IR_LED_PWM: U1.63 (GPIO32); also elsewhere on the board
MDM_CTS: U1.95 (GPIO52/ADC2_CHANNEL3); also elsewhere on the board
MDM_DTR: U1.98 (GPIO54/ADC2_CHANNEL5); also elsewhere on the board
MDM_RTS: U1.94 (GPIO51/ADC2_CHANNEL2); also elsewhere on the board
MDM_RXD: U1.92 (GPIO49/ADC2_CHANNEL0); also elsewhere on the board
MDM_STATUS: U1.97 (GPIO53/ADC2_CHANNEL4); also elsewhere on the board
MDM_TXD: U1.93 (GPIO50/ADC2_CHANNEL1); also elsewhere on the board
MODEM_PWRKEY_CTL: U1.7 (GPIO7); also elsewhere on the board
MODEM_PWR_EN: U1.8 (GPIO8); also elsewhere on the board
MODEM_RESET_CTL: U1.12 (GPIO11); also elsewhere on the board
MODEM_RI_3V3: U1.4 (GPIO4); also elsewhere on the board
PIR_OUT: U1.2 (GPIO2); also elsewhere on the board
SDIO_CLK: U1.19 (GPIO18/ADC1_CHANNEL2); also elsewhere on the board
SDIO_CMD: U1.20 (GPIO19/ADC1_CHANNEL3); also elsewhere on the board
SDIO_D0: U1.15 (GPIO14); also elsewhere on the board
SDIO_D1: U1.16 (GPIO15); also elsewhere on the board
SDIO_D2: U1.17 (GPIO16/ADC1_CHANNEL0); also elsewhere on the board
SDIO_D3: U1.18 (GPIO17/ADC1_CHANNEL1); also elsewhere on the board
SD_CLK: U1.84 (GPIO43); also elsewhere on the board
SD_CMD: U1.86 (GPIO44); also elsewhere on the board
SD_D0: U1.80 (GPIO39); also elsewhere on the board
SD_D1: U1.81 (GPIO40); also elsewhere on the board
SD_D2: U1.82 (GPIO41); also elsewhere on the board
SD_D3: U1.83 (GPIO42); also elsewhere on the board
SD_DET: U1.87 (GPIO45); also elsewhere on the board
SD_PWR_EN: U1.57 (GPIO28); also elsewhere on the board
SYS_SCL: U1.6 (GPIO6); also elsewhere on the board
SYS_SDA: U1.5 (GPIO5); also elsewhere on the board
USB_DN: R315.2; also elsewhere on the board
USB_DP: R314.2; also elsewhere on the board
VDD_FLASH: C316.1, C317.1, C331.1, R310.2, U1.30 (VDD_FLASH_IO), U1.71 (VDDO_FLASH), U2.8 (VCC)
VDD_HP: C311.1, C312.1, C313.1, C314.1, C315.1, C329.1, C330.1, L301.2, R302.1, U1.26 (VDD_HP_0), U1.54 (VDD_HP_1), U1.76 (VDD_HP_2), U1.91 (VDD_HP_3)
VDD_MIPI: C322.1, C323.1, C324.1, U1.41 (VDD_MIPI_DPHY), U1.73 (VDDO_3)
VDD_PSRAM: C318.1, C319.1, C320.1, C321.1, U1.59 (VDD_PSRAM_0), U1.67 (VDD_PSRAM_1), U1.72 (VDDO_PSRAM)

Notes on the sheet:
Chip rev v3.x (ESP32-P4NRW32X): VDD_HP_1 on pin 54; DC-DC feedback 499k/499k/22pF populated (HDG fig. 5).
VDD_MIPI_DPHY fed from internal VDDO_3 (2.5 V) as on ESP32-P4-Function-EV v1.5.2. VDD_USBPHY unused (HS PHY not used).
VDD_IO_6 = 1.8 V: GPIO49-54 talk to the SIM7600 UART natively. Keep these pins hi-Z while VBAT_LTE is off.

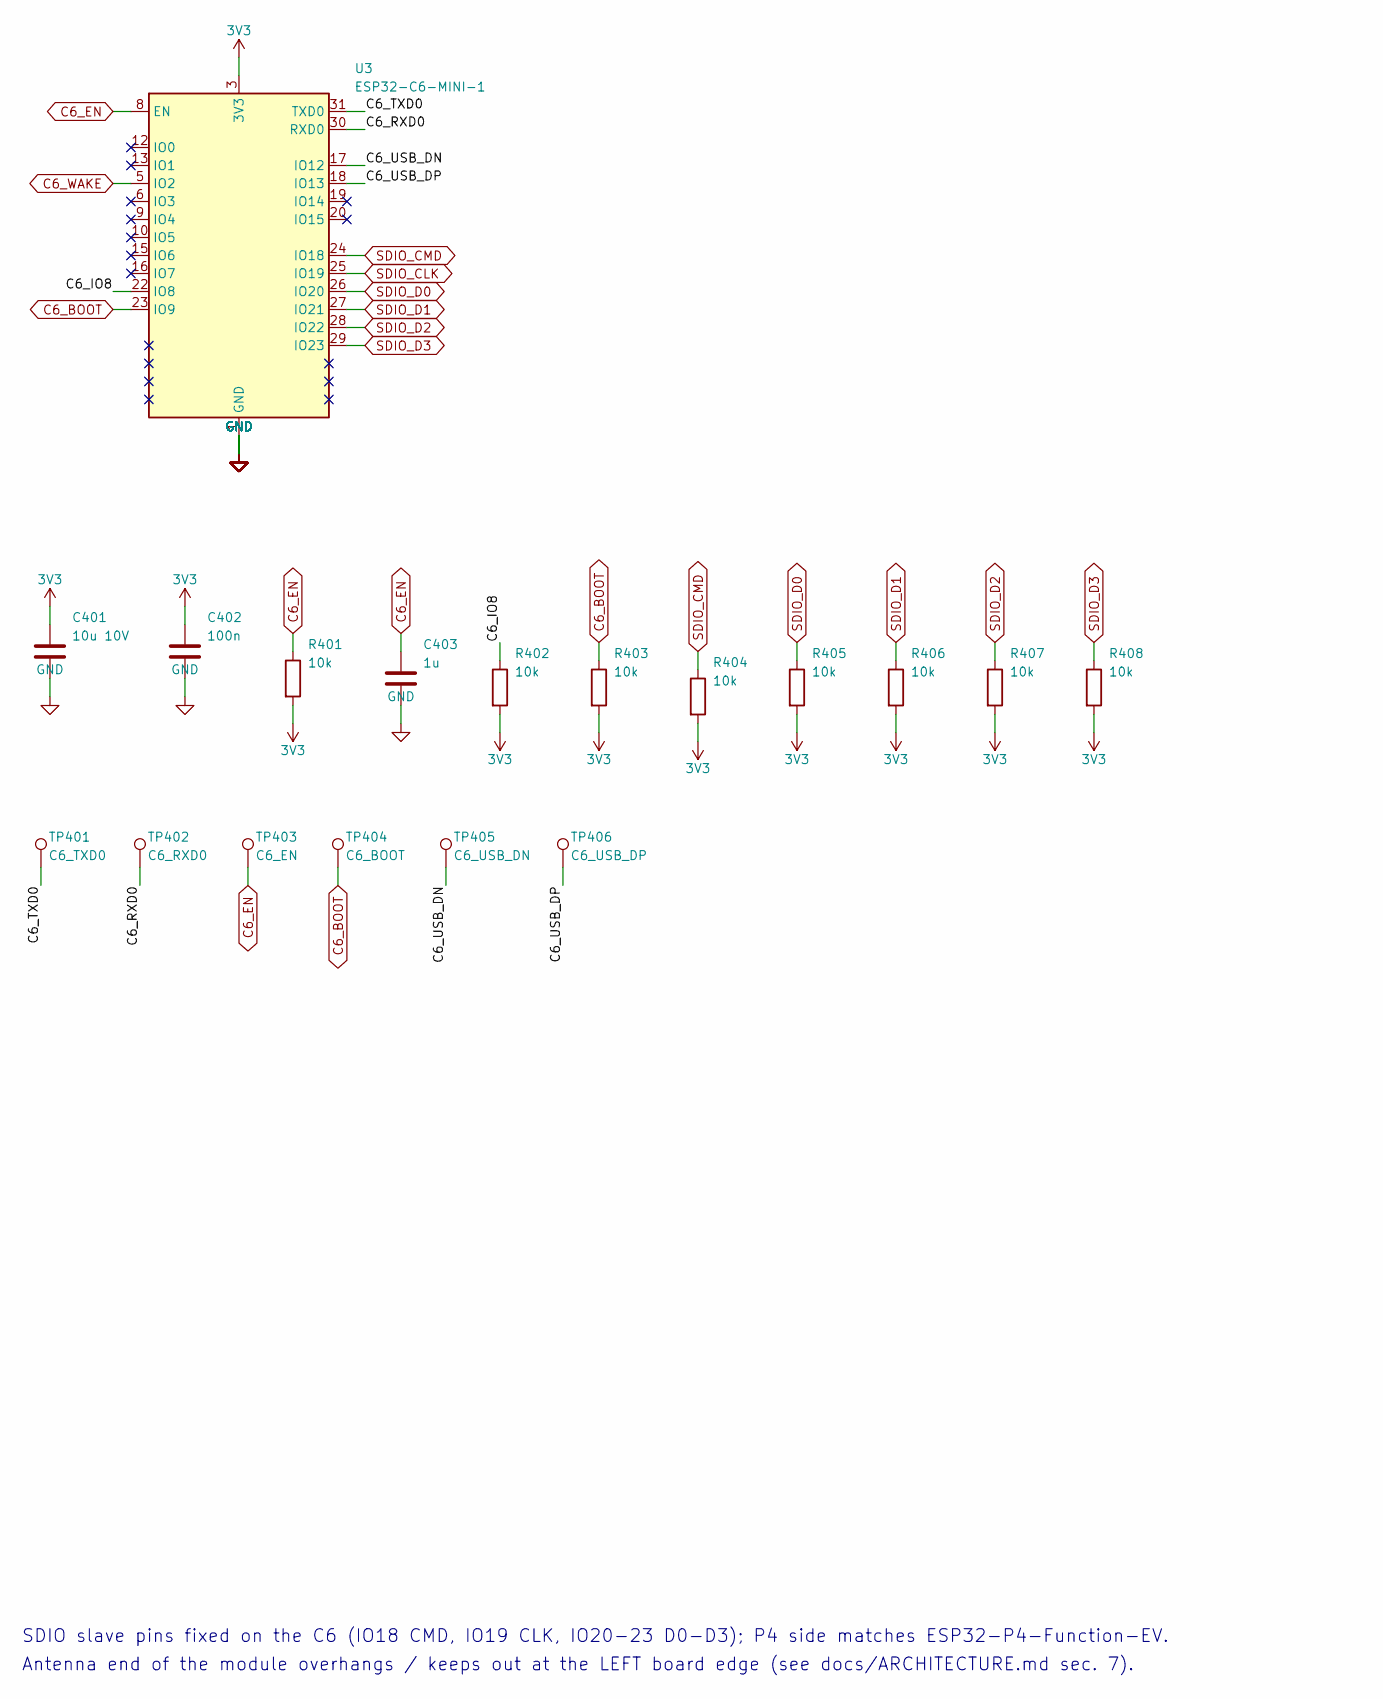
[picture p19: schematic wifi.kicad_sch, Wi-Fi 6 / BLE - ESP32-C6-MINI-1 over SDIO (esp-hosted)]

Parts:
C401: 10u 10V; C_0603_1608Metric; MPN CL10A106KP8NNNC; LCSC C19702
C402: 100n; C_0402_1005Metric; MPN CL05B104KO5NNNC; LCSC C1525
C403: 1u; C_0402_1005Metric; MPN CL05A105KA5NQNC; LCSC C52923
R401, R402, R403, R404, R405, R406, R407, R408: 10k; R_0402_1005Metric; MPN 0402WGF1002TCE; LCSC C25744
TP401: C6_TXD0; TestPoint_Pad_D1.0mm
TP402: C6_RXD0; TestPoint_Pad_D1.0mm
TP403: C6_EN; TestPoint_Pad_D1.0mm
TP404: C6_BOOT; TestPoint_Pad_D1.0mm
TP405: C6_USB_DN; TestPoint_Pad_D1.0mm
TP406: C6_USB_DP; TestPoint_Pad_D1.0mm
U3: ESP32-C6-MINI-1; MPN ESP32-C6-MINI-1-N4; LCSC C5453904

Connections:
3V3: C401.1, C402.1, R401.2, R402.2, R403.2, R404.2, R405.2, R406.2, R407.2, R408.2, U3.3 (3V3); also elsewhere on the board
/wifi/C6_IO8: R402.1, U3.22 (IO8)
/wifi/C6_RXD0: TP402.1, U3.30 (RXD0)
/wifi/C6_TXD0: TP401.1, U3.31 (TXD0)
/wifi/C6_USB_DN: TP405.1, U3.17 (IO12)
/wifi/C6_USB_DP: TP406.1, U3.18 (IO13)
C6_BOOT: R403.1, TP404.1, U3.23 (IO9); also elsewhere on the board
C6_EN: C403.1, R401.1, TP403.1, U3.8 (EN); also elsewhere on the board
C6_WAKE: U3.5 (IO2); also elsewhere on the board
GND: C401.2, C402.2, C403.2, U3.1 (GND), U3.2 (GND), U3.11 (GND), U3.14 (GND), U3.36 (GND), U3.37 (GND), U3.38 (GND), U3.39 (GND), U3.40 (GND), U3.41 (GND), U3.42 (GND), U3.43 (GND), U3.44 (GND), U3.45 (GND), U3.46 (GND), U3.47 (GND), U3.48 (GND), U3.49 (GND), U3.50 (GND), U3.51 (GND), U3.52 (GND), U3.53 (GND); also elsewhere on the board
SDIO_CLK: U3.25 (IO19); also elsewhere on the board
SDIO_CMD: R404.1, U3.24 (IO18); also elsewhere on the board
SDIO_D0: R405.1, U3.26 (IO20); also elsewhere on the board
SDIO_D1: R406.1, U3.27 (IO21); also elsewhere on the board
SDIO_D2: R407.1, U3.28 (IO22); also elsewhere on the board
SDIO_D3: R408.1, U3.29 (IO23); also elsewhere on the board

Notes on the sheet:
SDIO slave pins fixed on the C6 (IO18 CMD, IO19 CLK, IO20-23 D0-D3); P4 side matches ESP32-P4-Function-EV.
Antenna end of the module overhangs / keeps out at the LEFT board edge (see docs/ARCHITECTURE.md sec. 7).
