xmyoot/esp32-p4-midi-lte/esp32p4_lte_cam.kicad_pcb

## KiCad design esp32p4_lte_cam.kicad_pcb (continued)

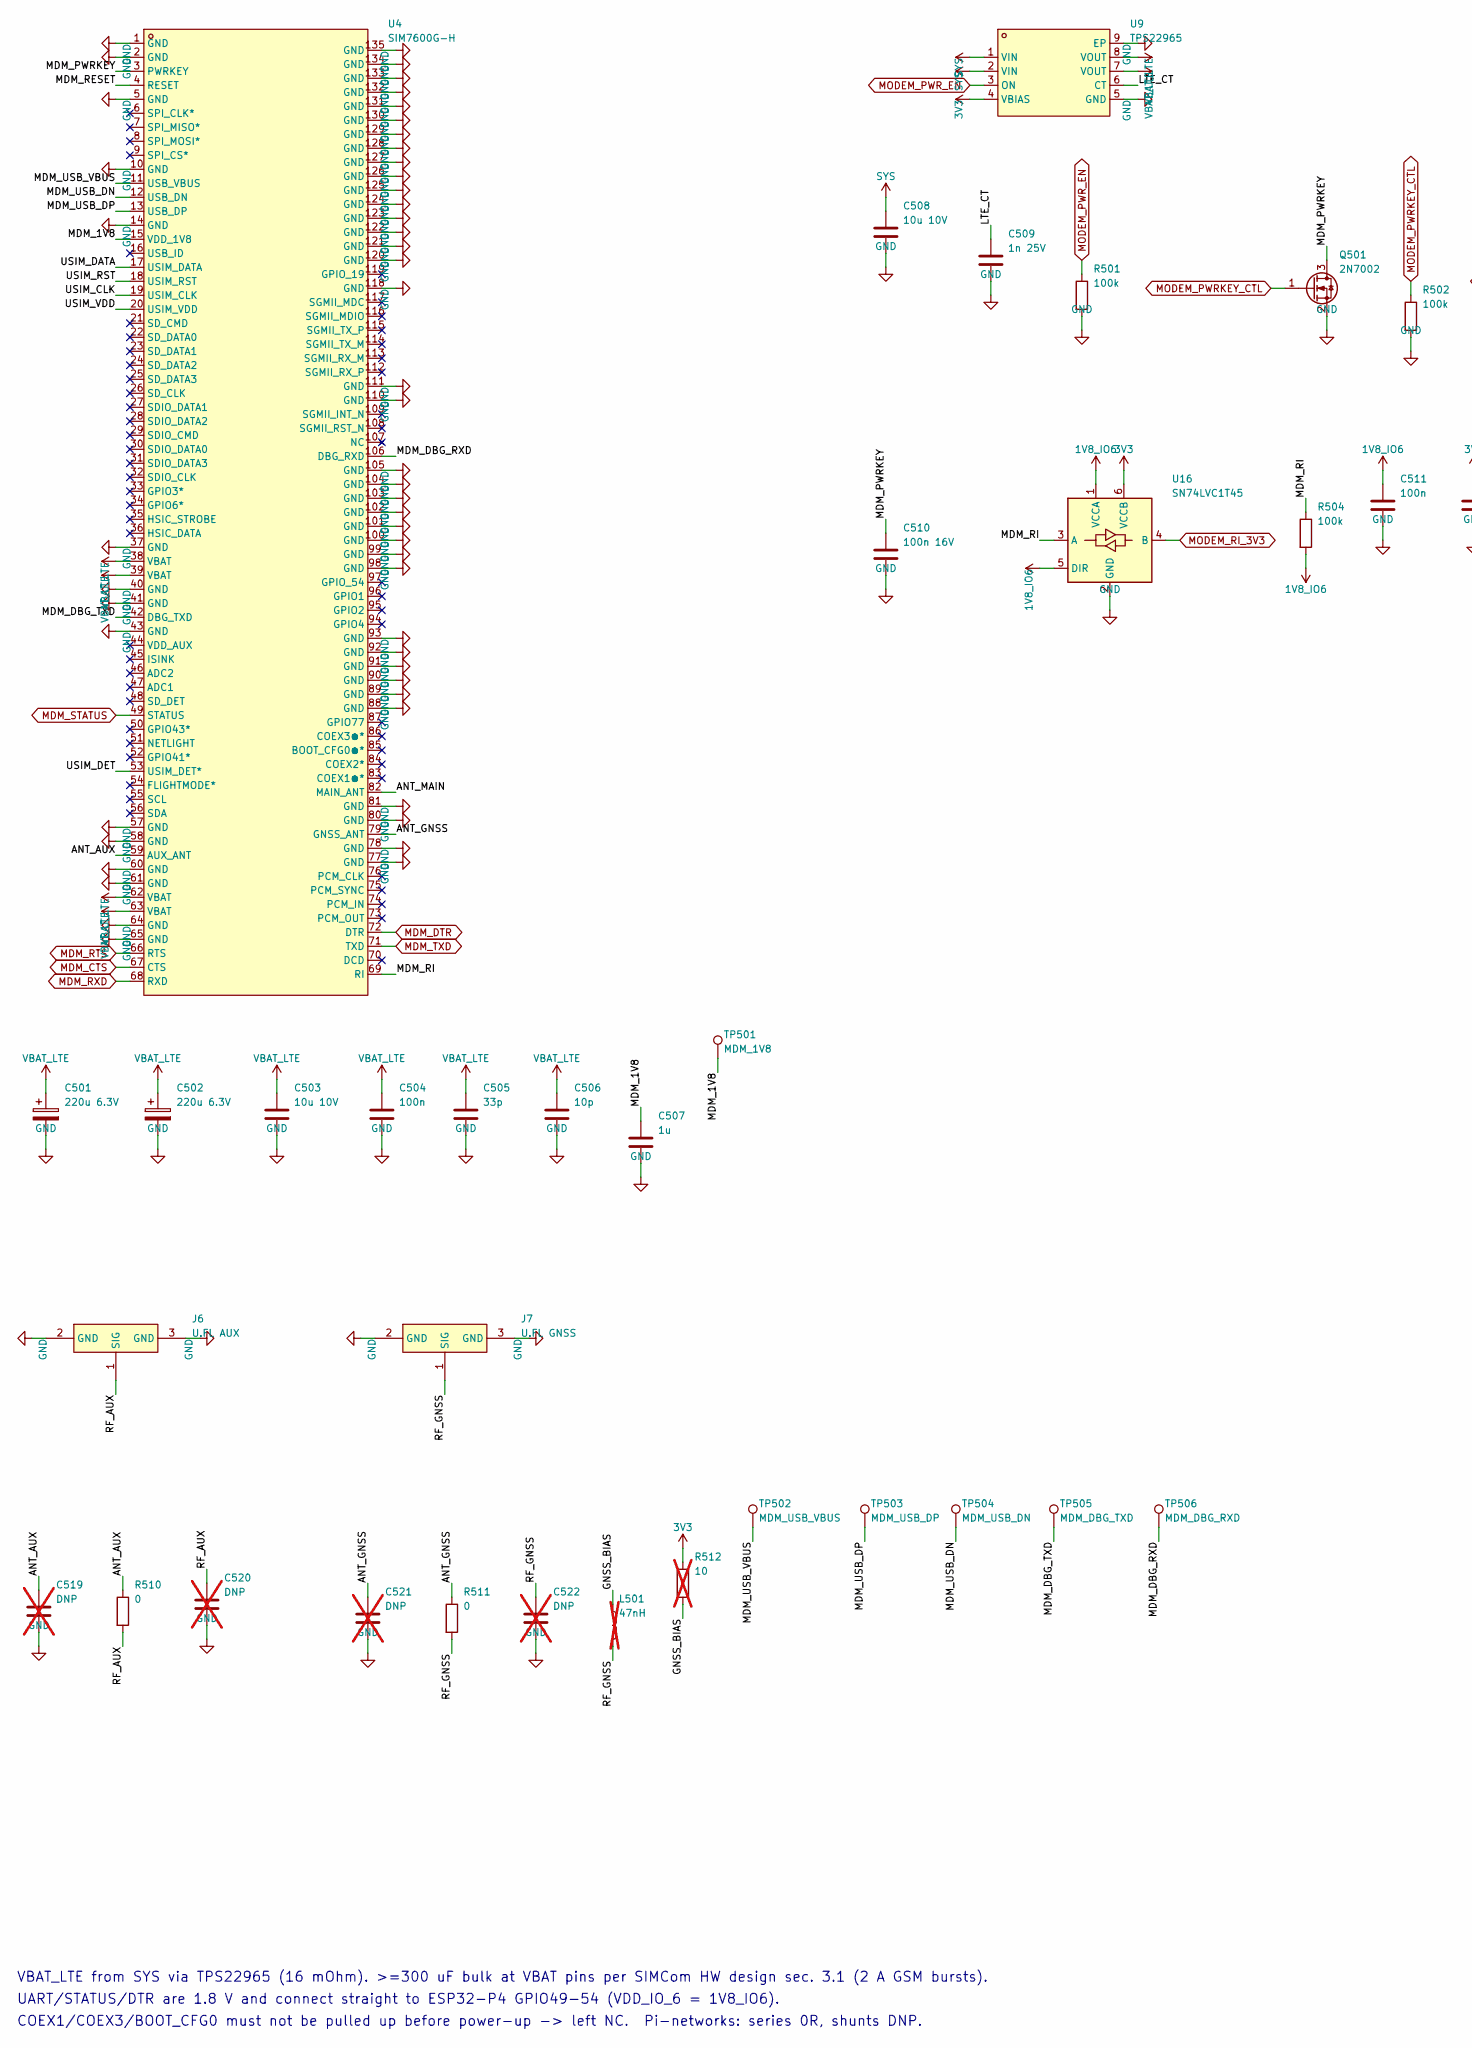
[picture p20: schematic lte.kicad_sch, LTE Cat-4 + GNSS - SIM7600G-H, nano-SIM, antennas, part in row 1, column 1]

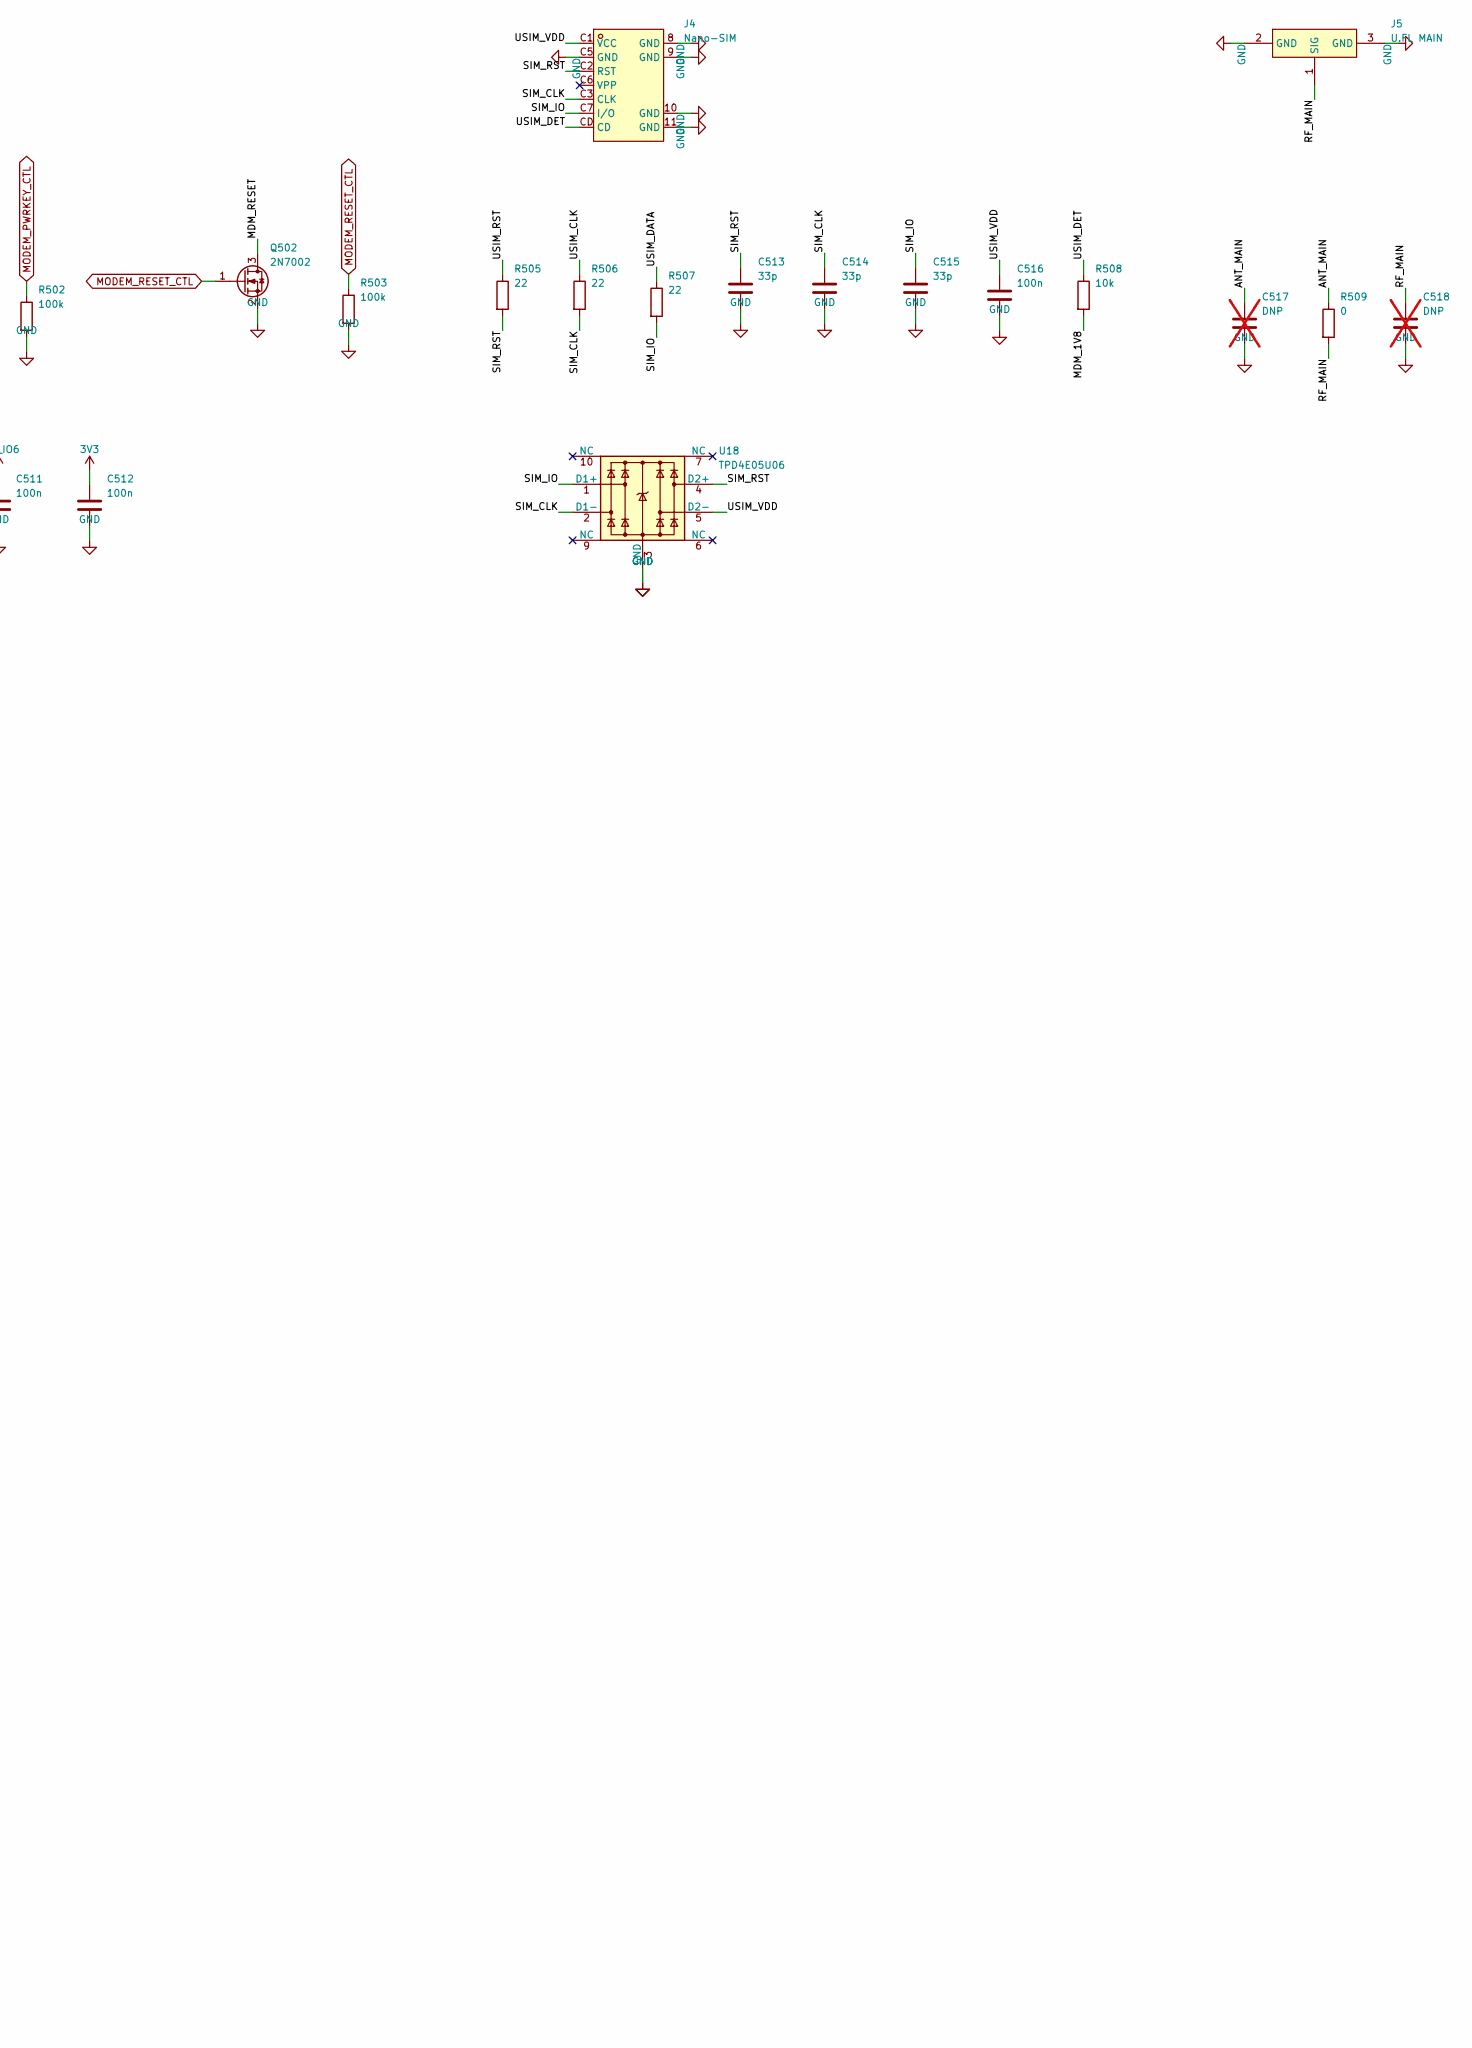
[picture p21: schematic lte.kicad_sch, LTE Cat-4 + GNSS - SIM7600G-H, nano-SIM, antennas, part in row 1, column 2]

Parts:
C501, C502: 220u 6.3V; CP_EIA-3528-21_Kemet-B; MPN TLJB227M006R0500; LCSC C30242
C503: 10u 10V; C_0603_1608Metric; MPN CL10A106KP8NNNC; LCSC C19702
C504, C511, C512, C516: 100n; C_0402_1005Metric; MPN CL05B104KO5NNNC; LCSC C1525
C505, C513, C514, C515: 33p; C_0402_1005Metric; MPN 0402CG330J500NT; LCSC C1562
C506: 10p; C_0402_1005Metric; MPN CL05C100JB5NNNC; LCSC C32949
C507: 1u; C_0402_1005Metric; MPN CL05A105KA5NQNC; LCSC C52923
C508: 10u 10V; C_0805_2012Metric; MPN CL21A106KPFNNNE; LCSC C17024
C509: 1n 25V; C_0402_1005Metric; MPN CC0402KRX7R8BB102; LCSC C541372
C510: 100n 16V; C_0402_1005Metric; MPN CL05B104KO5NNNC; LCSC C1525
C517, C518, C519, C520, C521, C522: DNP; C_0402_1005Metric; not fitted
J4: Nano-SIM; SIM-SMD_NANO-SIM-7P-H1.37; MPN NANO SIM 7P H1.37; LCSC C7529384
J5: U.FL MAIN; RF-SMD_FRF05002-JSS103M; MPN U.FL-R-SMT-1(80); LCSC C88374
J6: U.FL AUX; RF-SMD_FRF05002-JSS103M; MPN U.FL-R-SMT-1(80); LCSC C88374
J7: U.FL GNSS; RF-SMD_FRF05002-JSS103M; MPN U.FL-R-SMT-1(80); LCSC C88374
L501: 47nH; L_0402_1005Metric; MPN SDCL1005C47NJTDF; LCSC C27151; not fitted
Q501, Q502: 2N7002; SOT-23; MPN 2N7002; LCSC C8545
R501, R502, R503, R504: 100k; R_0402_1005Metric; MPN 0402WGF1003TCE; LCSC C25741
R505, R506, R507: 22; R_0402_1005Metric; MPN 0402WGF220JTCE; LCSC C25092
R508: 10k; R_0402_1005Metric; MPN 0402WGF1002TCE; LCSC C25744
R509, R510, R511: 0; R_0402_1005Metric; MPN 0402WGF0000TCE; LCSC C17168
R512: 10; R_0402_1005Metric; MPN 0402WGF100JTCE; LCSC C25077; not fitted
TP501: MDM_1V8; TestPoint_Pad_D1.0mm
TP502: MDM_USB_VBUS; TestPoint_Pad_D1.0mm
TP503: MDM_USB_DP; TestPoint_Pad_D1.0mm
TP504: MDM_USB_DN; TestPoint_Pad_D1.0mm
TP505: MDM_DBG_TXD; TestPoint_Pad_D1.0mm
TP506: MDM_DBG_RXD; TestPoint_Pad_D1.0mm
U4: SIM7600G-H; COMM-SMD_135P-L30.0-W30.0_SIM7600G; MPN SIM7600G-H; LCSC C5355477
U9: TPS22965; UDFN-8_L2.0-W2.0-P0.50-TL-EP; MPN TPS22965DSGR; LCSC C122837
U16: SN74LVC1T45; SOT-23-6; MPN SN74LVC1T45DBVR; LCSC C7843
U18: TPD4E05U06; USON-10_2.5x1.0mm_P0.5mm; MPN TPD4E05U06DQAR; LCSC C138714

Connections:
1V8_IO6: C511.1, R504.2, U16.1 (VCCA), U16.5 (DIR); also elsewhere on the board
3V3: C512.1, R512.1, U9.4 (VBIAS), U16.6 (VCCB); also elsewhere on the board
/lte/ANT_AUX: C519.1, R510.1, U4.59 (AUX_ANT)
/lte/ANT_GNSS: C521.1, R511.1, U4.79 (GNSS_ANT)
/lte/ANT_MAIN: C517.1, R509.1, U4.82 (MAIN_ANT)
/lte/GNSS_BIAS: L501.1, R512.2
/lte/LTE_CT: C509.1, U9.6 (CT)
/lte/MDM_1V8: C507.1, R508.2, TP501.1, U4.15 (VDD_1V8)
/lte/MDM_DBG_RXD: TP506.1, U4.106 (DBG_RXD)
/lte/MDM_DBG_TXD: TP505.1, U4.42 (DBG_TXD)
/lte/MDM_PWRKEY: C510.1, Q501.3 (D), U4.3 (PWRKEY)
/lte/MDM_RESET: Q502.3 (D), U4.4 (RESET)
/lte/MDM_RI: R504.1, U4.69 (RI), U16.3 (A)
/lte/MDM_USB_DN: TP504.1, U4.12 (USB_DN)
/lte/MDM_USB_DP: TP503.1, U4.13 (USB_DP)
/lte/MDM_USB_VBUS: TP502.1, U4.11 (USB_VBUS)
/lte/RF_AUX: C520.1, J6.1 (SIG), R510.2
/lte/RF_GNSS: C522.1, J7.1 (SIG), L501.2, R511.2
/lte/RF_MAIN: C518.1, J5.1 (SIG), R509.2
/lte/SIM_CLK: C514.1, J4.C3 (CLK), R506.2, U18.2 (D1-)
/lte/SIM_IO: C515.1, J4.C7 (I/O), R507.2, U18.1 (D1+)
/lte/SIM_RST: C513.1, J4.C2 (RST), R505.2, U18.4 (D2+)
/lte/USIM_CLK: R506.1, U4.19 (USIM_CLK)
/lte/USIM_DATA: R507.1, U4.17 (USIM_DATA)
/lte/USIM_DET: J4.CD, R508.1, U4.53 (USIM_DET*)
/lte/USIM_RST: R505.1, U4.18 (USIM_RST)
/lte/USIM_VDD: C516.1, J4.C1 (VCC), U4.20 (USIM_VDD), U18.5 (D2-)
GND: C501.2, C502.2, C503.2, C504.2, C505.2, C506.2, C507.2, C508.2, C509.2, C510.2, C511.2, C512.2, C513.2, C514.2, C515.2, C516.2, C517.2, C518.2, C519.2, C520.2, C521.2, C522.2, J4.8 (GND), J4.9 (GND), J4.10 (GND), J4.11 (GND), J4.C5 (GND), J5.2 (GND), J5.3 (GND), J6.2 (GND), J6.3 (GND), J7.2 (GND), J7.3 (GND), Q501.2 (S), Q502.2 (S), R501.2, R502.2, R503.2, U4.1 (GND), U4.2 (GND), U4.5 (GND), U4.10 (GND), U4.14 (GND), U4.37 (GND), U4.40 (GND), U4.41 (GND), U4.43 (GND), U4.57 (GND), U4.58 (GND), U4.60 (GND), U4.61 (GND), U4.64 (GND), U4.65 (GND), U4.77 (GND), U4.78 (GND), U4.80 (GND), U4.81 (GND), U4.88 (GND), U4.89 (GND), U4.90 (GND), U4.91 (GND), U4.92 (GND), U4.93 (GND), U4.98 (GND), U4.99 (GND), U4.100 (GND), U4.101 (GND), U4.102 (GND), U4.103 (GND), U4.104 (GND), U4.105 (GND), U4.110 (GND), U4.111 (GND), U4.118 (GND), U4.120 (GND), U4.121 (GND), U4.122 (GND), U4.123 (GND), U4.124 (GND), U4.125 (GND), U4.126 (GND), U4.127 (GND), U4.128 (GND), U4.129 (GND), U4.130 (GND), U4.131 (GND), U4.132 (GND), U4.133 (GND), U4.134 (GND), U4.135 (GND), U9.5 (GND), U9.9 (EP), U16.2 (GND), U18.3 (GND), U18.8 (GND); also elsewhere on the board
MDM_CTS: U4.67 (CTS); also elsewhere on the board
MDM_DTR: U4.72 (DTR); also elsewhere on the board
MDM_RTS: U4.66 (RTS); also elsewhere on the board
MDM_RXD: U4.68 (RXD); also elsewhere on the board
MDM_STATUS: U4.49 (STATUS); also elsewhere on the board
MDM_TXD: U4.71 (TXD); also elsewhere on the board
MODEM_PWRKEY_CTL: Q501.1 (G), R502.1; also elsewhere on the board
MODEM_PWR_EN: R501.1, U9.3 (ON); also elsewhere on the board
MODEM_RESET_CTL: Q502.1 (G), R503.1; also elsewhere on the board
MODEM_RI_3V3: U16.4 (B); also elsewhere on the board
SYS: C508.1, U9.1 (VIN), U9.2 (VIN); also elsewhere on the board
VBAT_LTE: C501.1, C502.1, C503.1, C504.1, C505.1, C506.1, U4.38 (VBAT), U4.39 (VBAT), U4.62 (VBAT), U4.63 (VBAT), U9.7 (VOUT), U9.8 (VOUT)

Notes on the sheet:
VBAT_LTE from SYS via TPS22965 (16 mOhm). >=300 uF bulk at VBAT pins per SIMCom HW design sec. 3.1 (2 A GSM bursts).
UART/STATUS/DTR are 1.8 V and connect straight to ESP32-P4 GPIO49-54 (VDD_IO_6 = 1V8_IO6).
COEX1/COEX3/BOOT_CFG0 must not be pulled up before power-up -> left NC. Pi-networks: series 0R, shunts DNP.

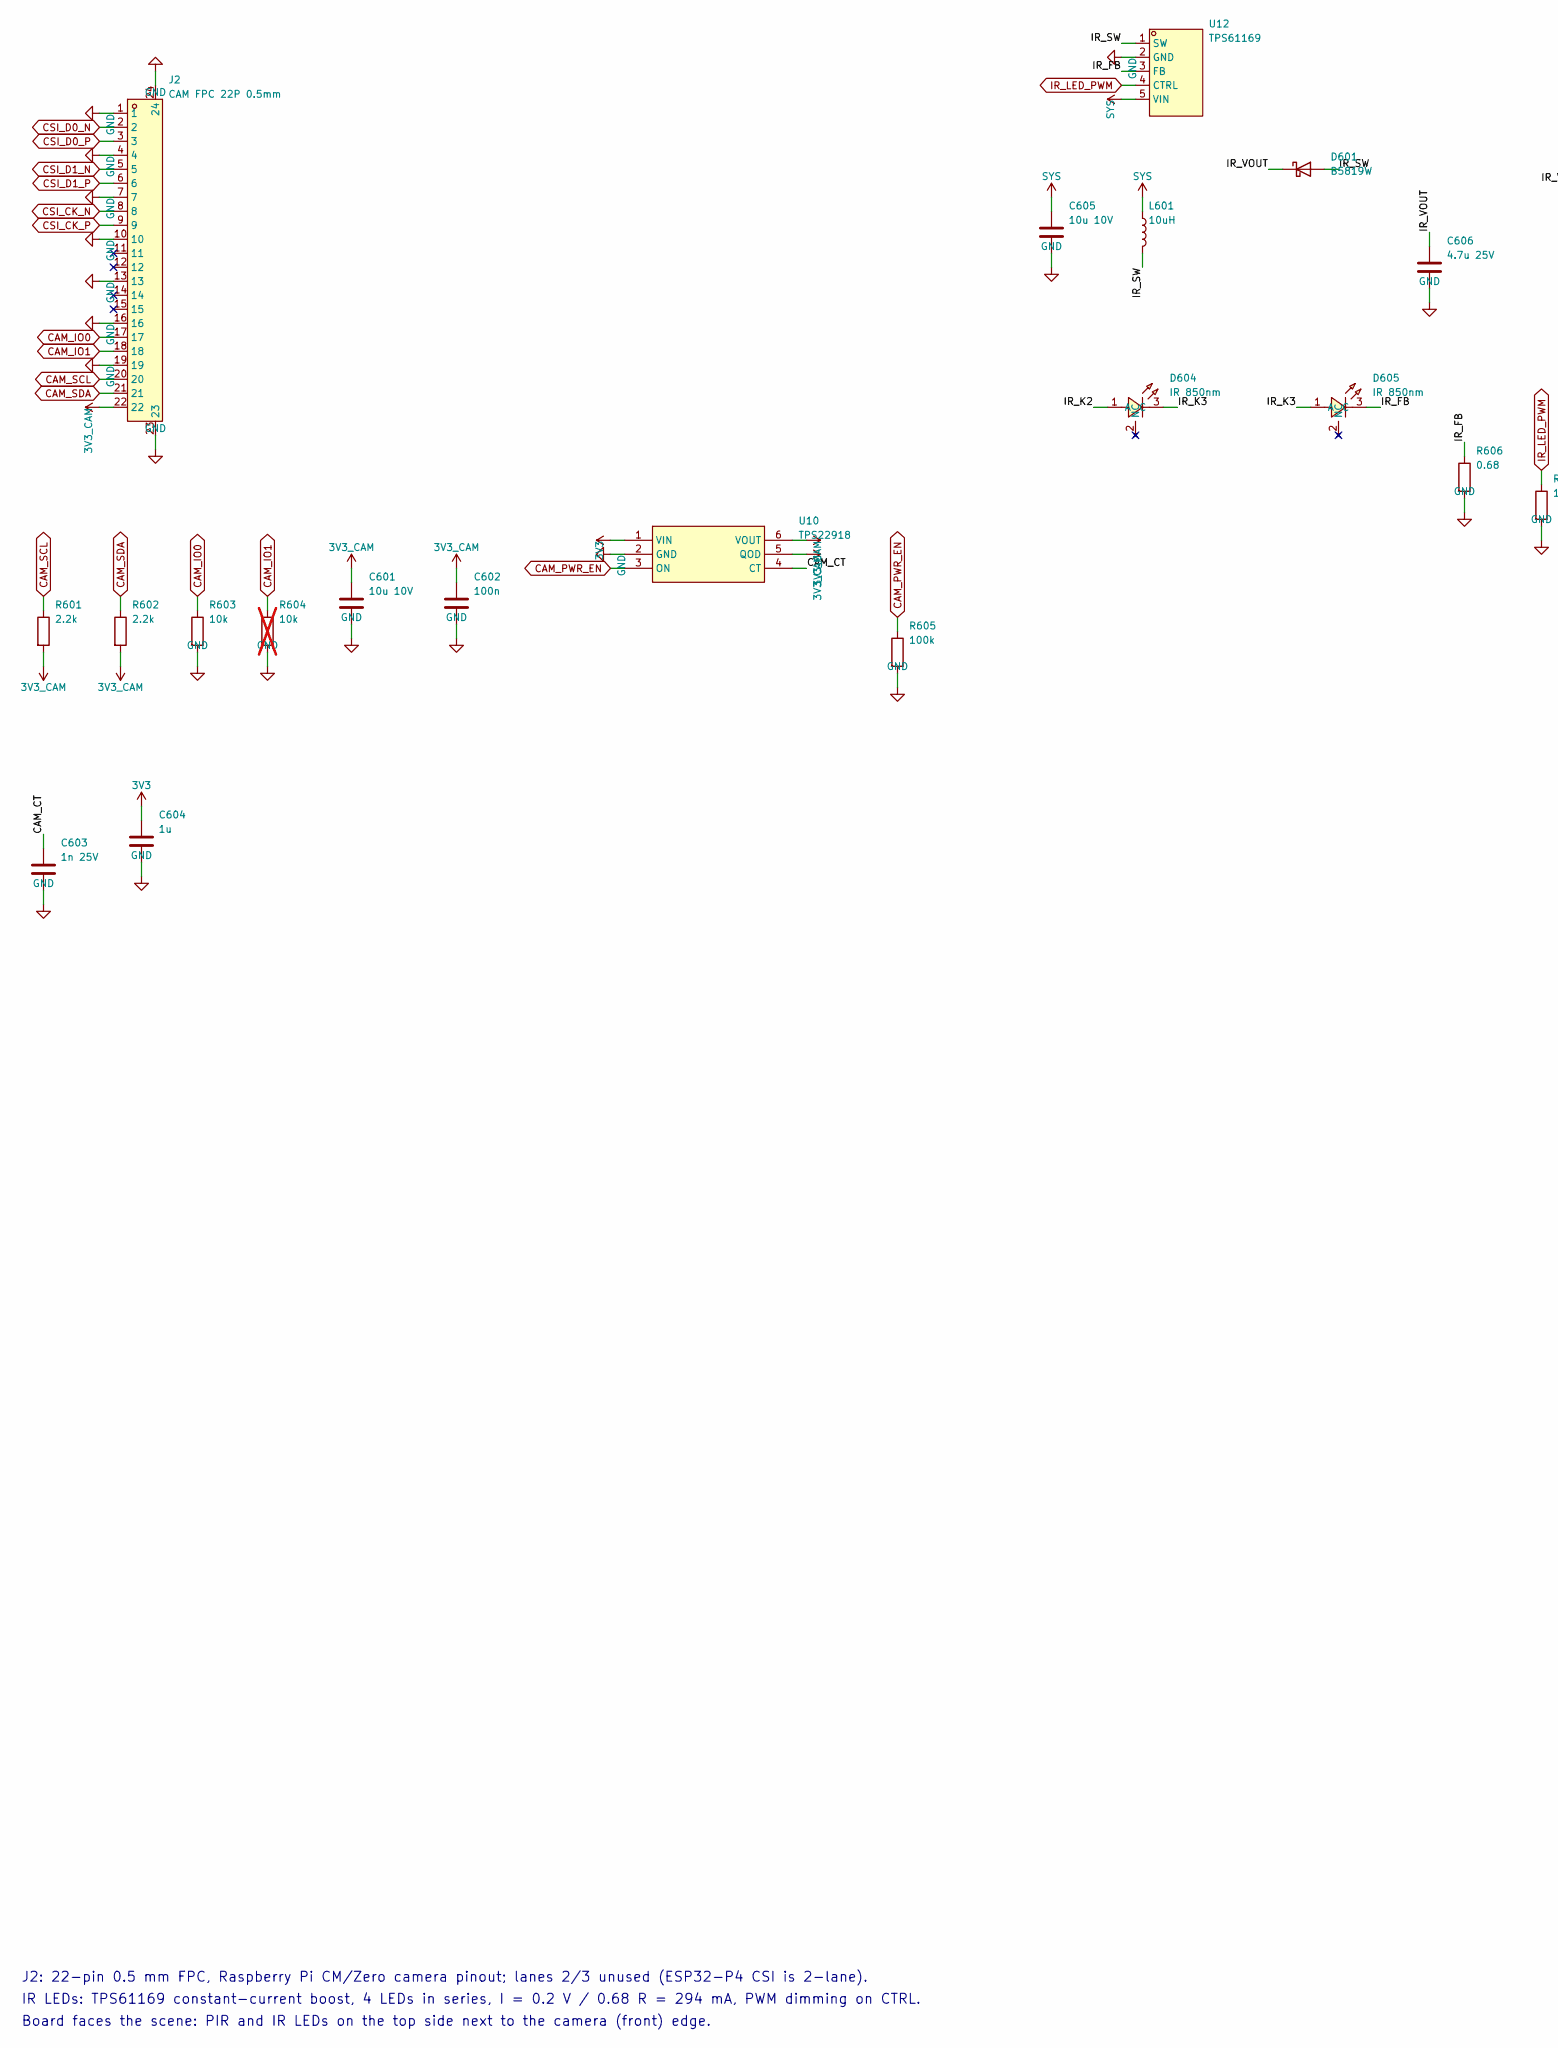
[picture p22: schematic camera_ir.kicad_sch, Camera (MIPI CSI-2, 2 lanes), IR illumination, IR-cut filte…, part in row 1, column 1]

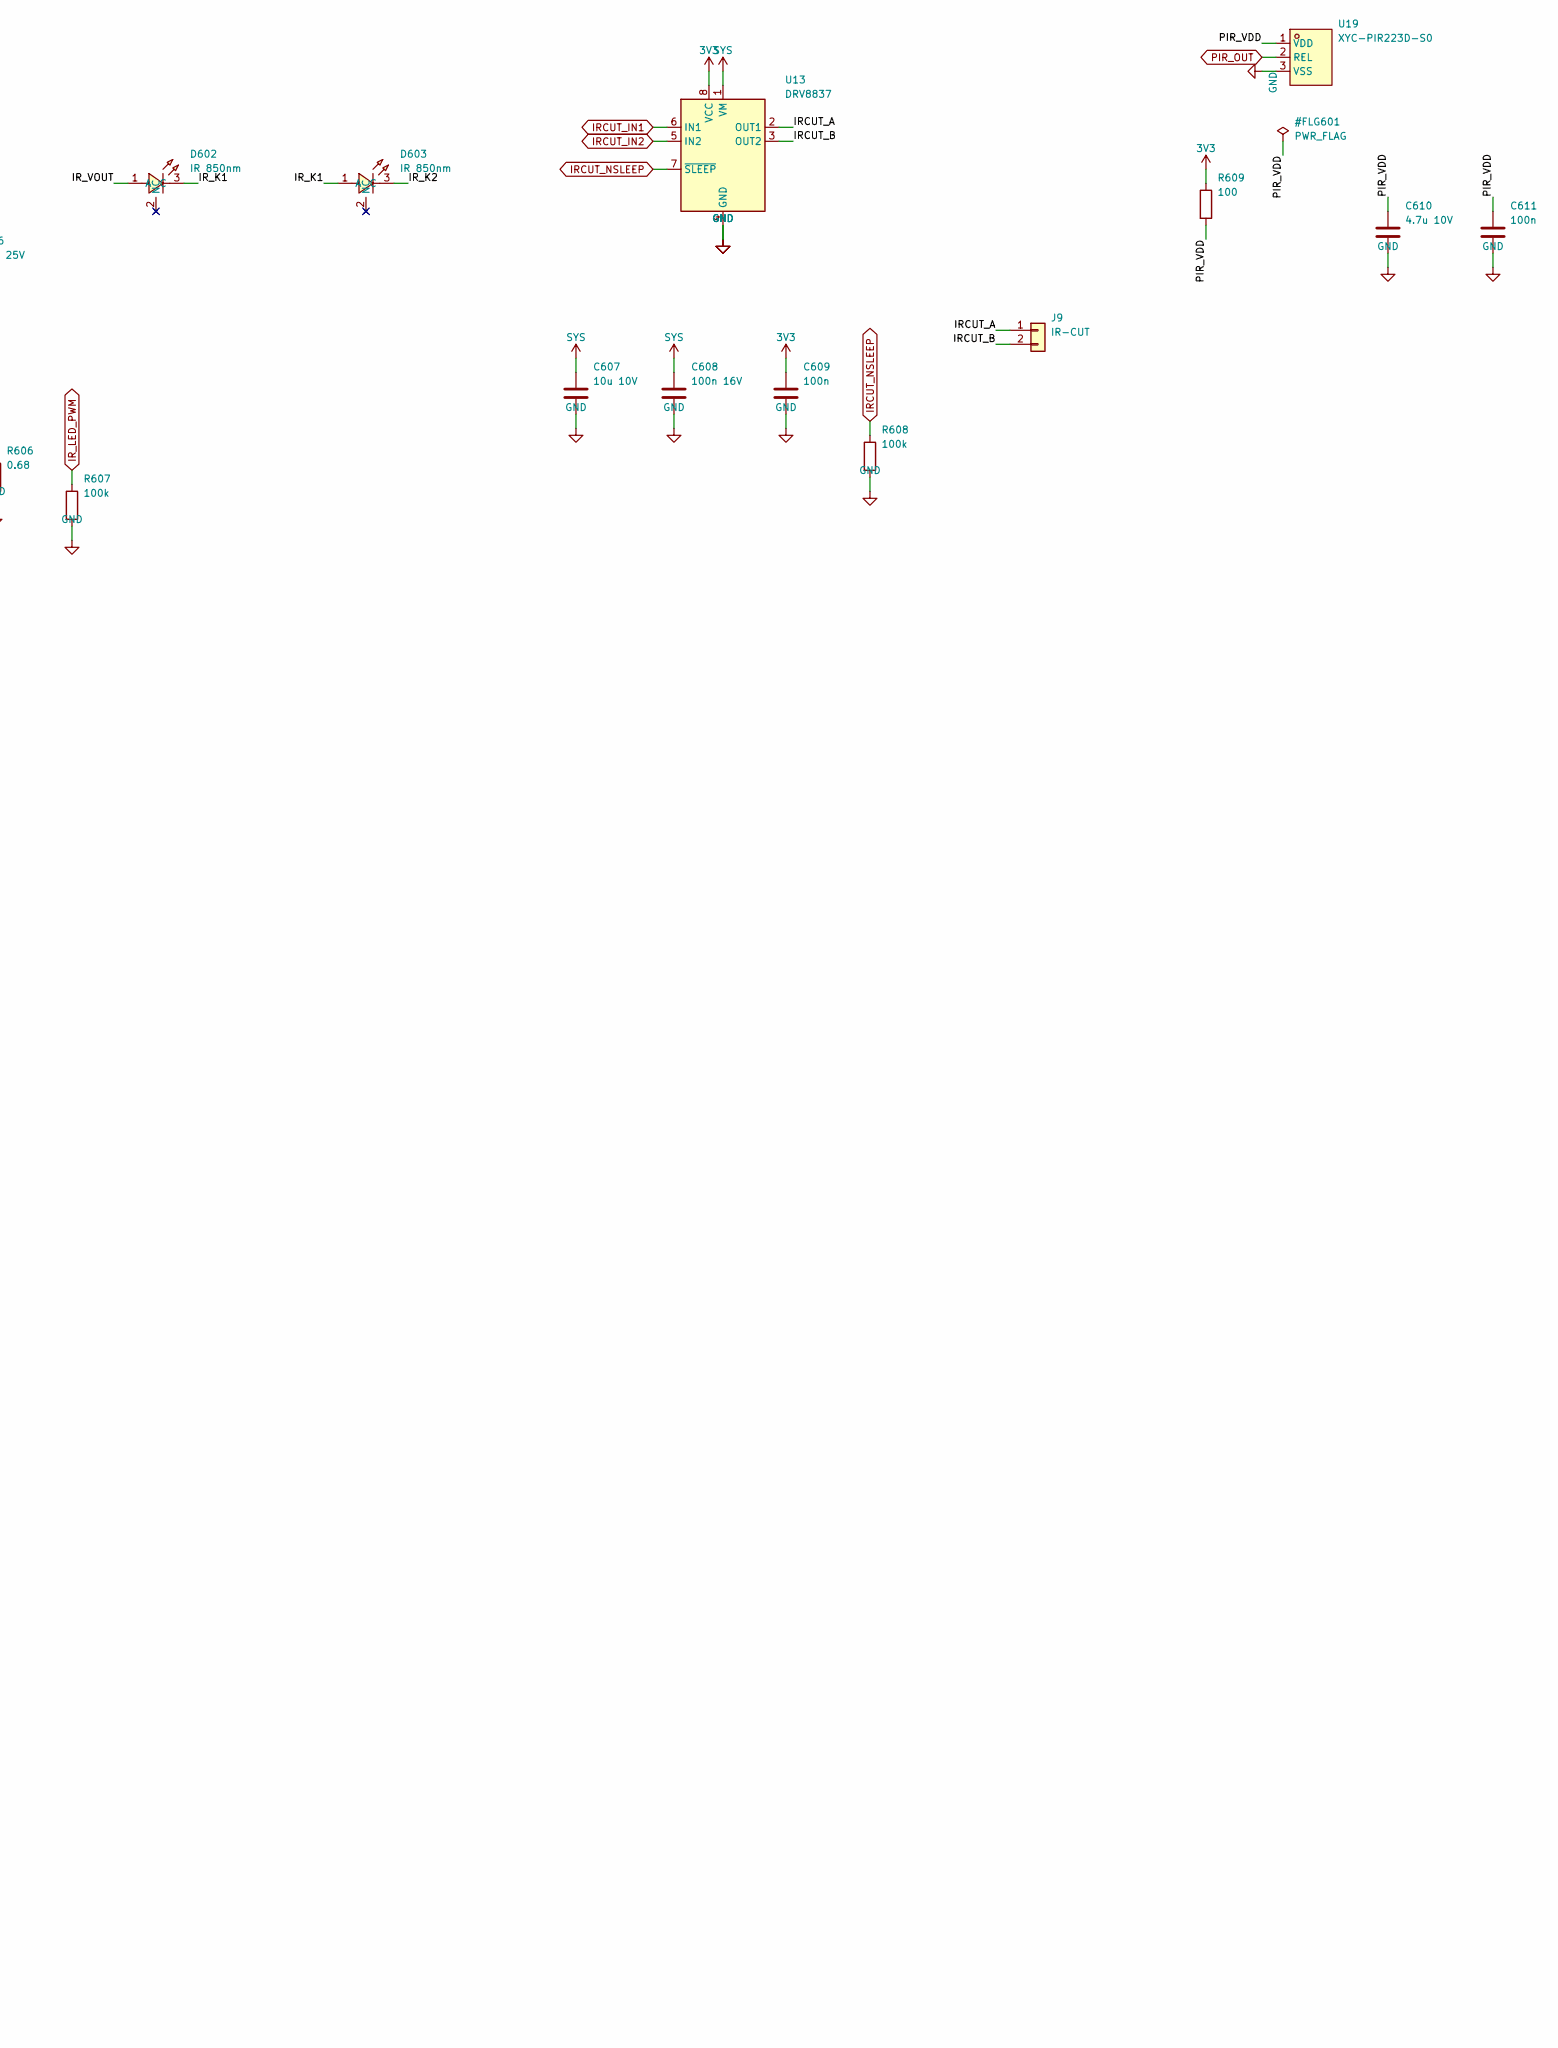
[picture p23: schematic camera_ir.kicad_sch, Camera (MIPI CSI-2, 2 lanes), IR illumination, IR-cut filte…, part in row 1, column 2]

Parts:
C601: 10u 10V; C_0603_1608Metric; MPN CL10A106KP8NNNC; LCSC C19702
C602, C609, C611: 100n; C_0402_1005Metric; MPN CL05B104KO5NNNC; LCSC C1525
C603: 1n 25V; C_0402_1005Metric; MPN CC0402KRX7R8BB102; LCSC C541372
C604: 1u; C_0402_1005Metric; MPN CL05A105KA5NQNC; LCSC C52923
C605, C607: 10u 10V; C_0805_2012Metric; MPN CL21A106KPFNNNE; LCSC C17024
C606: 4.7u 25V; C_0805_2012Metric; MPN CL21A475KAQNNNE; LCSC C1779
C608: 100n 16V; C_0402_1005Metric; MPN CL05B104KO5NNNC; LCSC C1525
C610: 4.7u 10V; C_0603_1608Metric; MPN CL10A475KP8NNNC; LCSC C1705
D601: B5819W; D_SOD-123; MPN B5819W SL; LCSC C8598
D602, D603, D604, D605: IR 850nm; LED-SMD_3P-L3.8-W3.8_M3838E1IRS1G09; MPN M3838E1IRS1G09-850NM; LCSC C2833567
J2: CAM FPC 22P 0.5mm; CONN-SMD_05B20L22P; MPN 05B20L22P; LCSC C22459552
J9: IR-CUT; JST_SH_SM02B-SRSS-TB_1x02-1MP_P1.00mm_Horizontal; MPN SM02B-SRSS-TB(LF)(SN); LCSC C160402
L601: 10uH; IND-SMD_L4.0-W4.0; MPN SWPA4030S100MT; LCSC C38117
R601, R602: 2.2k; R_0402_1005Metric; MPN 0402WGF2201TCE; LCSC C25879
R603: 10k; R_0402_1005Metric; MPN 0402WGF1002TCE; LCSC C25744
R604: 10k; R_0402_1005Metric; MPN 0402WGF1002TCE; LCSC C25744; not fitted
R605, R607, R608: 100k; R_0402_1005Metric; MPN 0402WGF1003TCE; LCSC C25741
R606: 0.68; R_0805_2012Metric; MPN 0805W8F680LT5E; LCSC C47389
R609: 100; R_0402_1005Metric; MPN 0402WGF1000TCE; LCSC C25076
U10: TPS22918; SOT-23-6_L2.9-W1.6-P0.95-LS2.8-BR; MPN TPS22918DBVR; LCSC C131941
U12: TPS61169; SC-70-5_L2.1-W1.3-P0.65-LS2.1-BR; MPN TPS61169DCKR; LCSC C71045
U13: DRV8837; Texas_DSG0008A_WSON-8-1EP_2x2mm_P0.5mm_EP0.9x1.6mm; MPN DRV8837DSGR; LCSC C39159
U19: XYC-PIR223D-S0; TO-5-3_L8.2-W8.2; MPN XYC-PIR223D-S0; LCSC C2887901

Connections:
3V3: C604.1, C609.1, R609.1, U10.1 (VIN), U13.8 (VCC); also elsewhere on the board
3V3_CAM: C601.1, C602.1, J2.22, R601.2, R602.2, U10.5 (QOD), U10.6 (VOUT)
/camera_ir/CAM_CT: C603.1, U10.4 (CT)
/camera_ir/IRCUT_A: J9.1, U13.2 (OUT1)
/camera_ir/IRCUT_B: J9.2, U13.3 (OUT2)
/camera_ir/IR_FB: D605.3 (C), R606.1, U12.3 (FB)
/camera_ir/IR_K1: D602.3 (C), D603.1 (A)
/camera_ir/IR_K2: D603.3 (C), D604.1 (A)
/camera_ir/IR_K3: D604.3 (C), D605.1 (A)
/camera_ir/IR_SW: D601.2 (A), L601.2, U12.1 (SW)
/camera_ir/IR_VOUT: C606.1, D601.1 (K), D602.1 (A)
/camera_ir/PIR_VDD: C610.1, C611.1, R609.2, U19.1 (VDD)
CAM_IO0: J2.17, R603.1; also elsewhere on the board
CAM_IO1: J2.18, R604.1; also elsewhere on the board
CAM_PWR_EN: R605.1, U10.3 (ON); also elsewhere on the board
CAM_SCL: J2.20, R601.1; also elsewhere on the board
CAM_SDA: J2.21, R602.1; also elsewhere on the board
CSI_CK_N: J2.8; also elsewhere on the board
CSI_CK_P: J2.9; also elsewhere on the board
CSI_D0_N: J2.2; also elsewhere on the board
CSI_D0_P: J2.3; also elsewhere on the board
CSI_D1_N: J2.5; also elsewhere on the board
CSI_D1_P: J2.6; also elsewhere on the board
GND: C601.2, C602.2, C603.2, C604.2, C605.2, C606.2, C607.2, C608.2, C609.2, C610.2, C611.2, J2.1, J2.4, J2.7, J2.10, J2.13, J2.16, J2.19, J2.23, J2.24, R603.2, R604.2, R605.2, R606.2, R607.2, R608.2, U10.2 (GND), U12.2 (GND), U13.4 (GND), U13.9 (GND), U19.3 (VSS); also elsewhere on the board
IRCUT_IN1: U13.6 (IN1); also elsewhere on the board
IRCUT_IN2: U13.5 (IN2); also elsewhere on the board
IRCUT_NSLEEP: R608.1, U13.7 (~SLEEP); also elsewhere on the board
IR_LED_PWM: R607.1, U12.4 (CTRL); also elsewhere on the board
PIR_OUT: U19.2 (REL); also elsewhere on the board
SYS: C605.1, C607.1, C608.1, L601.1, U12.5 (VIN), U13.1 (VM); also elsewhere on the board

Notes on the sheet:
J2: 22-pin 0.5 mm FPC, Raspberry Pi CM/Zero camera pinout; lanes 2/3 unused (ESP32-P4 CSI is 2-lane).
IR LEDs: TPS61169 constant-current boost, 4 LEDs in series, I = 0.2 V / 0.68 R = 294 mA, PWM dimming on CTRL.
Board faces the scene: PIR and IR LEDs on the top side next to the camera (front) edge.

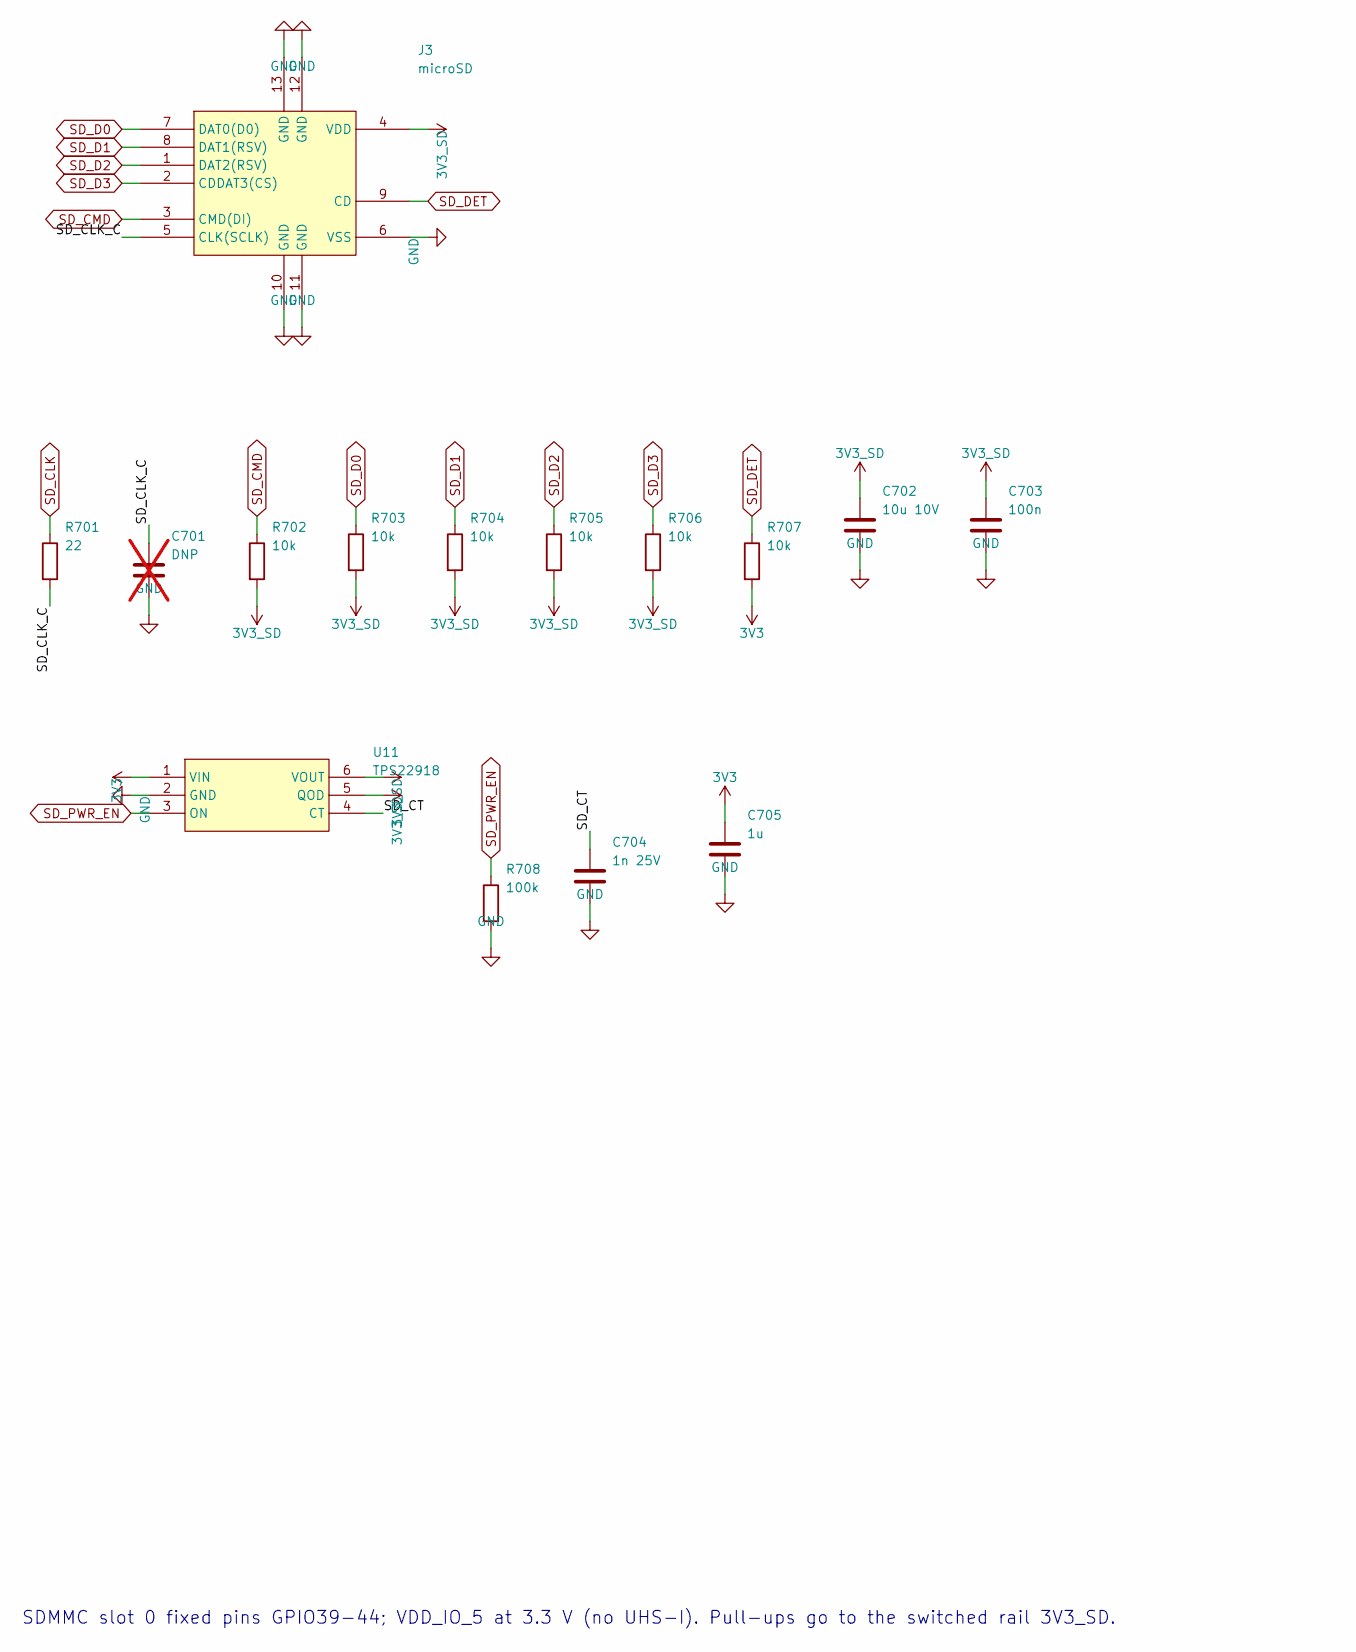
[picture p24: schematic storage.kicad_sch, microSD (SDMMC slot 0, 4-bit, 3.3 V) with power switch]

Parts:
C701: DNP; C_0402_1005Metric; not fitted
C702: 10u 10V; C_0603_1608Metric; MPN CL10A106KP8NNNC; LCSC C19702
C703: 100n; C_0402_1005Metric; MPN CL05B104KO5NNNC; LCSC C1525
C704: 1n 25V; C_0402_1005Metric; MPN CC0402KRX7R8BB102; LCSC C541372
C705: 1u; C_0402_1005Metric; MPN CL05A105KA5NQNC; LCSC C52923
J3: microSD; TF-SMD_TF-01A; MPN TF-01A; LCSC C91145
R701: 22; R_0402_1005Metric; MPN 0402WGF220JTCE; LCSC C25092
R702, R703, R704, R705, R706, R707: 10k; R_0402_1005Metric; MPN 0402WGF1002TCE; LCSC C25744
R708: 100k; R_0402_1005Metric; MPN 0402WGF1003TCE; LCSC C25741
U11: TPS22918; SOT-23-6_L2.9-W1.6-P0.95-LS2.8-BR; MPN TPS22918DBVR; LCSC C131941

Connections:
3V3: C705.1, R707.2, U11.1 (VIN); also elsewhere on the board
3V3_SD: C702.1, C703.1, J3.4 (VDD), R702.2, R703.2, R704.2, R705.2, R706.2, U11.5 (QOD), U11.6 (VOUT)
/storage/SD_CLK_C: C701.1, J3.5 (CLK(SCLK)), R701.2
/storage/SD_CT: C704.1, U11.4 (CT)
GND: C701.2, C702.2, C703.2, C704.2, C705.2, J3.6 (VSS), J3.10 (GND), J3.11 (GND), J3.12 (GND), J3.13 (GND), R708.2, U11.2 (GND); also elsewhere on the board
SD_CLK: R701.1; also elsewhere on the board
SD_CMD: J3.3 (CMD(DI)), R702.1; also elsewhere on the board
SD_D0: J3.7 (DAT0(D0)), R703.1; also elsewhere on the board
SD_D1: J3.8 (DAT1(RSV)), R704.1; also elsewhere on the board
SD_D2: J3.1 (DAT2(RSV)), R705.1; also elsewhere on the board
SD_D3: J3.2 (CDDAT3(CS)), R706.1; also elsewhere on the board
SD_DET: J3.9 (CD), R707.1; also elsewhere on the board
SD_PWR_EN: R708.1, U11.3 (ON); also elsewhere on the board

Notes on the sheet:
SDMMC slot 0 fixed pins GPIO39-44; VDD_IO_5 at 3.3 V (no UHS-I). Pull-ups go to the switched rail 3V3_SD.
