xmyoot/esp32-p4-midi-lte/esp32p4_lte_cam.kicad_pcb

## KiCad design esp32p4_lte_cam.kicad_pcb (continued)

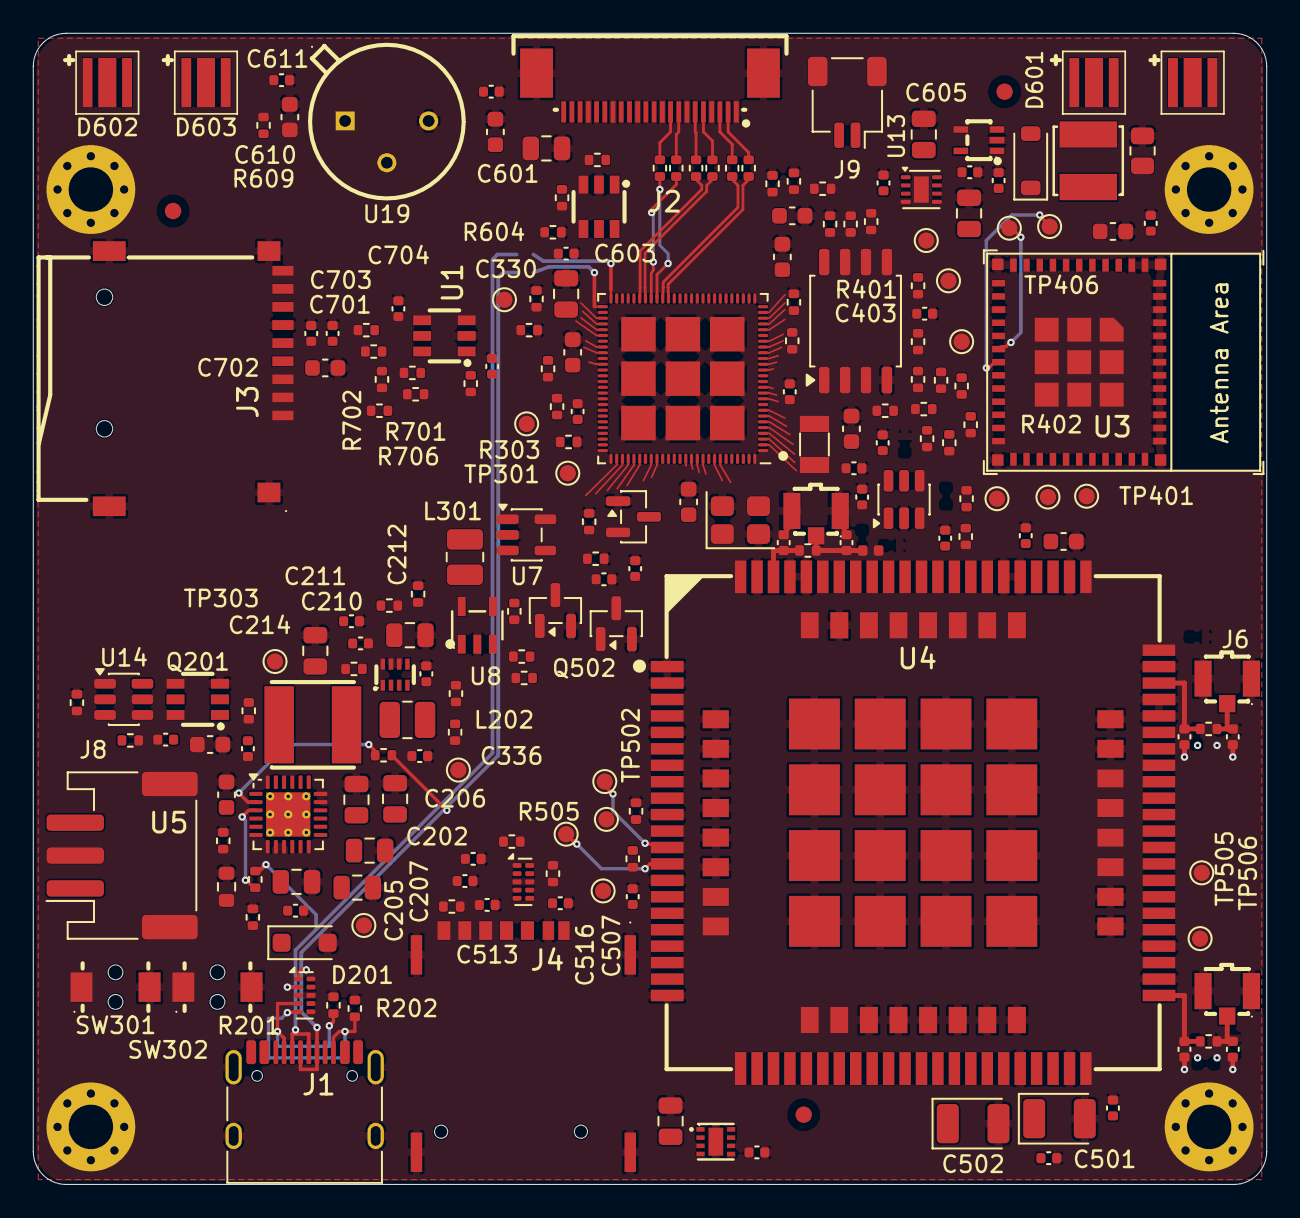
[picture p25: board esp32p4_lte_cam.kicad_pcb from above]

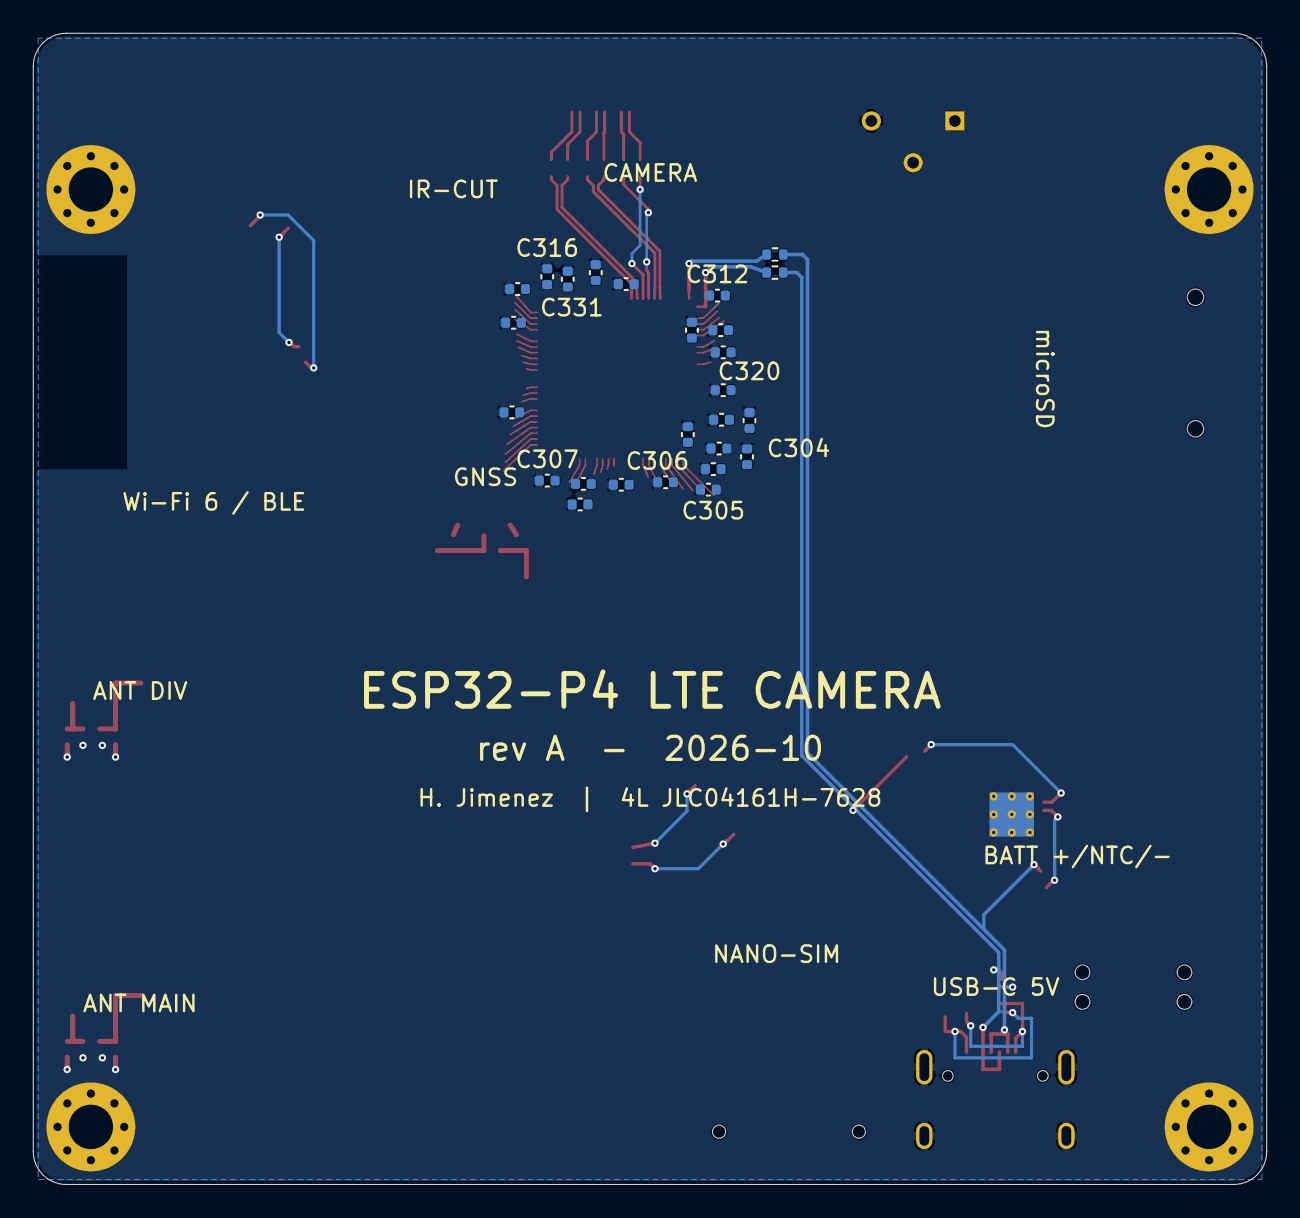
[picture p26: board esp32p4_lte_cam.kicad_pcb from below]

Board: 4 copper layers, 75.0 x 70.0 mm, 238 parts (26 on the bottom side), 160 nets.

Other parts of the board:
FID1, FID2, FID3: Fiducial; Fiducial_1mm_Mask2mm
H1, H2, H3, H4: M2.5; MountingHole_2.7mm_M2.5_Pad_Via

Their connections:
GND: H1.1, H2.1, H3.1, H4.1; also elsewhere on the board
