xmyoot/esp32-p4-midi-lte/(commit log)

2026-10-20 Phase 0-2: project setup, architecture, rev A schematic
    - KiCad 10 project skeleton, vendored Espressif + LCSC libraries,
    tooling scripts (LCSC import, JLC search, passive resolver)
    - Design spec, architecture (Review 1 approved), floor plan fit check
    - Rev A schematic generated from scripts/build_sch.py: 6 sheets,
    199 placements, ERC 0 violations, every BOM line with LCSC + MPN
    - Review 2 package in docs/review (PDF, BOM, review notes)
    - Client brief screenshots and component datasheets
    [bom_revA_draft.csv, camera_ir.kicad_sch, esp32p4_lte_cam.kicad_pcb, esp32p4_lte_cam.kicad_sch, lte.kicad_sch, mcu.kicad_sch, power.kicad_sch, storage.kicad_sch]
2026-10-20 Phase 3: board setup
    - Netlist -> PCB sync script (keeps placement, schematic links, LCSC/MPN fields)
    - 75x70 mm outline, 4x M2.5 GND holes, JLC04161H-7628 stackup, L2 GND plane
    - Net classes by pattern (Power, HighCurrent, RF 50R CPWG, USB 90R, MIPI 100R),
    JLC-checked rules and custom DRC rules; impedance calculator script
    - Library fixes: peg holes -> NPTH, PIR courtyard, Espressif supply pin types
    - Short sheet names so local nets read /power/..., /mcu/...
    - DRC 0 violations; 231 footprints staged for placement
    [esp32p4_lte_cam.kicad_pcb, esp32p4_lte_cam.kicad_sch]
2026-10-20 Phase 4: placement (Review 3)
    - Scripted placement: anchors per floor plan + pin-attraction satellites
    (switch-node parts hug their regulator, decaps spread over owner pins);
    pad-aware collision boxes; optional --p4-decaps-bottom variant
    - P4 rotated 180 for a straight 11 mm CSI path; card slots moved to edges
    (nano-SIM bottom, microSD west); C6 module NE corner, antenna on edge
    - Fiducials, SIM7600 top-layer no-track rule area, bottom silk legends
    - Silkscreen tidy pipeline (KRT beautify_labels + DRC-driven hiding,
    clear-spot seating for key designators)
    - Library: imported silk trimmed off pads, P4 3D model, C6 model path
    - DRC 0 violations; renders, assembly drawing, metrics, revi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
    [esp32p4_lte_cam.kicad_pcb, variant_bottom_decaps.kicad_pcb]
2026-10-20 Phase 5 prep: bottom-side P4 decoupling, plane split, MIPI hand route
    - place.py: P4 decaps on B.Cu by default, U9 moved south-west of modem
    - planes.py: GND L1/L2/L4, hand split L3 (VBAT_LTE / SYS / 3V3)
    - route_mipi.py: coupled 100R CSI pairs, clock crossover via B.Cu
    - viewroute.py: region render of pads/tracks/vias
    - board_setup.py: MIPI intra-pair skew 0.3 mm
    [esp32p4_lte_cam.kicad_pcb]
2026-10-20 Phase 5: USB hookup (P4 escape, J1/ESD/CC hand route, BC1.2 taps)
    - place.py: anchor R314/R315 on B.Cu beside the P4 USB corner, keep-clear corridors
    - route_usb.py: P4 USB escape to the 22R pair; J1 -> B.Cu coupled pair
    (0.22/0.13) under U17 to R314/R315 with short ESD taps; CC1/CC2 to
    U17 and the 5.1k pull-downs via B.Cu links under the J1 pad row
    - CHG_DP/CHG_DN and the R203/R204 BC1.2 taps autorouted (KRT route.py)
    - DRC: no clearance violations; remaining items are unrouted nets
    [esp32p4_lte_cam.kicad_pcb]
2026-10-20 Phase 5: SIM7600 RF feeds (MAIN/AUX/GNSS CPWG, pi-match inline, GND fence)
    [esp32p4_lte_cam.kicad_pcb]
2026-10-21 Update routing and power tap scripts
